t-cun/OrangePiR1-schematics/README.md

# OrangePiR1-schematics
KiCad Schematics and PCB for the Orange Pi R1
