t-cun/OrangePiR1-schematics/KiCad/README.md

# LockboxHomePCB
Kicad Project / PCB files for LockboxHome PCB Design
