t-cun/OrangePiR1-schematics/Fabrication_Files/OrangePiR1_BOM_v1.0.xlsx

Project | OrangePiR1
Date | 2020-04-09
Item # | Designator | Part Number | Description | Manufacturer | Quantity
1 | LP1 | 74404063330 | SMD Inductor, 33uH, 1.22A, 185mOhm | Wurth Elektronik | 1
2 | U2 | RTL8152B | RTL8152B Series,Integrated 10/100M Ethernet Controller, QFN-24 | Realtek | 1
3 | J3 | M20-9990345 | Header, 2.54 mm pitch, 3 Contacts, 1 Row, TH | HARWIN | 1
4 | D30 | PDS5100 | Schottky Diodes, 5 A, 0.89 V, POWERDI-5 | Diodes Incorporated | 1
5 | U58 | MX25L1606EM1I-12G | 16-Mbit (2Mx8) 86 MHz Industrial Grade Serial Flash, SOP-8 | Macronix | 1
6 | D19 | NRVTS260ESF | Schottky Diode, 2A, 60V, SOD-123FL-2 | ON Semiconductor | 1
7 | U21 | CK-W-R189ETV-SM | WIFI module based on Realtek RTL189ETV, 12mm x 12mm x 1.5mm | Lingmeng Technology | 1
8 | U53 | SY8113B | High Efficiency, 500kHz, 3A, 16V Input Synchronous Step Down Regulator, TSOT-23-6 | Silergy Corp | 1
9 | CN5, CN4 | ARJP11A-MASA-B-A-EMU2 | Ethernet Connectors, Magnetic Jack 1 port, 100 Base TX, PCB mount, RA | ABRACON | 2
10 | D10, D11, D12, D13, D14, D15, D16, D17 | S215FA | Schottky Diode, 150V, 2A, SOD-123FA-2 | ON Semiconductor | 8
11 | CP14 | 592D477X06R3C2T20H | Tantalum Capacitor,470uF, 6.3V 20% C case, Solid SMD | Vishay | 1
12 | ANT1 | 2337019-1 | MicroCoax receptacle, SMD | TE Connectivity | 1
13 | U1 | Allwinner H2+ | Allwinner H2+ Quad-core 32-bit Cortex-A7, FBGA 347 balls | Allwinner | 1
14 | DU1 | K4B2G1646F-BYMA | DRAM Chip DDR3 SDRAM 2Gbit 128Mx16 1.5V 96-Pin FBGA | Samsung Electronics | 1
15 | J2 | 105162-0101 | Memory Card Connector, Mirco SD card, with CD pin | Molex | 1
16 | FB10, FB11, FB12, FB13 | BLM18SG331TN1D | Ferrite Bead, 330 ohm, 1.5 A, 0.07 ohm, ± 25%, 0603 | MURATA | 4
17 | FB14 | 742792609 | Ferrite Bead, 0603 [1608 Metric], 30 ohm, 3 A, WE-CBF Series, 0.04 ohm, ± 25% | Wurth Elektronik | 1
18 | U24 | SY6280AAC | PMIC - Power Distribution Switches SOT-23-5 RoHS | Silergy Corp | 1
19 | U54 | SST25VF016B | 16 Mbit SPI Serial Flash, SOIC-8 | Silicon Storage Technology / Microchip | 1
20 | U6 | MIC5219-3.3YM5-TR | Fixed LDO Voltage Regulator, 2.5V to 12V, 350mV Dropout, 3.3Vout, 500mAout, SOT-23-5 | MICROCHIP | 1
21 | U25 | BCM856BS,115 | Bipolar Transistors - BJT COMPLEX DISCRETE S2022D/SOT45 | NXP | 1
22 | Q9 | MMBT3904 | Transistor, NPN, 40 V, 300 MHz, 250 mW, 200 mA, SOT-23 | NXP | 1
23 | Q5 | BSN20-7 | Power MOSFET, N Channel, 50 V, 500 mA, 1.3 ohm, SOT-23 | DIODES INC. | 1
24 | Q10 | AO3415A | MOSFET, P-CH, 20V, 5A, SOT23-3 | Alpha & Omega Semiconductor Inc. | 1
25 | Q11 | AO3423 | MOSFET, P-CH, 20V, 2A, SOT23 | Alpha & Omega Semiconductor Inc. | 1
26 | X2 | TSX-3225 24.0000MF15X-AC6 | CRYSTAL, 24.00MHZ, 9.0PF, SMD | Epson | 1
27 | X5 | TSX-3225 25.0000MF10P-C0 | CRYSTAL 25.0000MHZ 18PF SMD | Epson | 1
28 | CN1 | 10118194-0001LF | USB2.0 Micro Connector, SMD R/A | Amphenol ICC (FCI) | 1
29 | D18 | XBS104S14R-G | DIODE SCHOTTKY, 40V, 1A, SOD123A | Torex Semiconductor Ltd | 1
30 | L3, L8 | SWPA4030S2R2NT | General Purpose Inductor, 2.2uH, 30%, 4.9A, 30mOhms, Ferrite-Core, SMD | SHENZHEN SUNLORD ELECTRONICS CO LTD | 2
31 | L1, L2, L9 | SWPA3015S2R2NT | General Purpose Inductor, 2.2uH, 30%, 1.6A, 60mOhms, Ferrite-Core, SMD | SHENZHEN SUNLORD ELECTRONICS CO LTD | 3
32 | U4, U5, U55 | SY8008B | High Efficiency 1.5MHz, 0.6A/1A/1.2A Synchronous Step Down Regulator, TSOT23-5 | Silergy Corp | 3
33 | U7 | SY8009A | High Efficiency 1.5MHz/1MHz, 1.5A/2A Synchronous Step Down Regulator , SOT23-5 | Silergy Corp | 1
34 | U20 | SI3402-B-GMR | Power Over Ethernet (POE) Controller, 57V Input, 350kHz, QFN-20
35 | D7 | KP-2012SYC | LED, Low Power, Yellow, SMD, 0805, 20 mA, 2 V, 590 nm | KINGBRIGHT | 1
36 | D8 | KP-2012SURC | LED, Low Power, Red, SMD, 0805, 20 mA, 1.9 V, 628 nm | KINGBRIGHT | 1
37 | D49 | KP-2012MGC | LED, Low Power, Green, SMD, 0805, 20mA, 2.1V, 570 nm | KINGBRIGHT | 1
38 | CON5 | 61301311121 | Board-To-Board Connector, Vertical, 2.54 mm, 13 Contacts, Header, TH | WURTH ELEKTRONIK | 1
39 | DR8, RP16 | RC0805FR-07100RL | Chip Resistor, 100 ohm, 150 V, 125 mW, 1%, 0805 | Yageo | 2
40 | R450, R451, R452, R453, RP17, | RC0402FR-07330RL | Chip Resistor, 330 ohm, 50 V, 63 mW, 1%, 0402 | Yageo | 5
41 | R35, R120 | RC0402FR-0733RL | Chip Resistor, 33 ohm, 50 V, 63 mW, 1%, 0402 | Yageo | 2
42 | DR1, DR2, DR5 | RC0402FR-07240RL | Chip Resistor, 240 ohm, 50 V, 63 mW, 1%, 0402 | Yageo | 3
43 | R157, RP15 | RC0402FR-0710KL. | Chip Resistor, 1K ohm, 50 V, 63 mW, 1%, 0402 | Yageo | 2
44 | RP14 | RC0402FR-073K3L | Chip Resistor, 3.3 Kohm, 50 V, 63 mW, 1%, 0402 | Yageo | 1
45 | RP12 | CRCW04023K24FKED | Chip Resistor, 3.24 Kohm, 50 V, 63 mW, 1%, 0402 | Vishay | 1
46 | RP13 | RC0402FR-07180RL | Chip Resistor, 180 ohm, 50 V, 63 mW, 1%, 0402 | Yageo | 1
47 | RP11 | ERJ2RKF4992X | Chip Resistor, 49.9 kohm, 50 V, 100 mW, 1%, 0402 | Panasonic | 1
48 | RP10 | CRCW040224K3FKED | Chip Resistor, 24.3 Kohm, 50 V, 63 mW, 1%, 0402 | Vishay | 1
49 | RP9 | ERJ2RKF4872X | Chip Resistor, 48.7 kohm, 50 V, 100 mW, 1%, 0402 | Panasonic | 1
50 | FB6 | RC0603JR-070RL | Chip Resistor, 0 ohm, 50 V, 100 mW, 1%, 0603
51 | R1, R12, R25, R26, R32, R46, R111, R388, R389, RP1,RP4, RP5, RP8, L10 | RC0402JR-070RL | Chip Resistor, 0 ohm, 50 V, 63 mW, 1%, 0402 | Yageo | 14
52 | DR6, DR7, R131, R132, R151, R152, R153, R154, R461 | RC0402FR-072KL | Chip Resistor, 2K ohm, 50 V, 63 mW, 1%, 0402 | Yageo | 9
53 | R37, R38, R40, R80, R127, R233, R340, R347, R346, R350, R349, R354, R355, R445, R458, R459 | RC0402FR-0710KL. | Chip Resistor, 10K ohm, 50 V, 63 mW, 1%, 0402 | Yageo | 18
54 | R455 | CRCW04022K49FKED | Chip Resistor, 2.49 Kohm, 50 V, 63 mW, 1%, 0402 | Vishay | 1
55 | R3, R18, R22, R449 | RC0402FR-07100KL | Chip Resistor, 100K ohm, 50 V, 63 mW, 1%, 0402 | Yageo | 4
56 | R448 | RC0402FR-0720KL | Chip Resistor, 20K ohm, 50 V, 63 mW, 1%, 0402 | Yageo | 1
57 | R447 | RC0402FR-0733KL | Chip Resistor, 33K ohm, 50 V, 63 mW, 1%, 0402 | Yageo | 1
58 | R13, R446 | RC0402FR-07150KL | Chip Resistor, 150K ohm, 50 V, 63 mW, 1%, 0402 | Yageo | 2
59 | R237 | CRCW040230K1FKED | Chip Resistor, 30.1 Kohm, 50 V, 63 mW, 1%, 0402 | Vishay | 1
60 | R235 | CRCW040211K8FKED | Chip Resistor, 11.8 Kohm, 50 V, 63 mW, 1%, 0402 | Vishay | 1
61 | R2, R16, R33, R34, R112, R113, R114, R115, R116, R117, R118, R123, R124 | RC0402FR-0747KL | Chip Resistor, 47K ohm, 50 V, 63 mW, 1%, 0402 | Yageo | 11
62 | R14, R24 | RC0402FR-07120KL | Chip Resistor, 120K ohm, 50 V, 63 mW, 1%, 0402 | Yageo | 2
63 | R19 | RC0402FR-072RL | Chip Resistor, 2 ohm, 50 V, 63 mW, 1%, 0402 | Yageo | 1
64 | R17 | CRCW0402442KFKED | Chip Resistor, 442K ohm, 50 V, 63 mW, 1%, 0402 | Vishay | 1
65 | R10 | RC0402FR-07220KL | Chip Resistor, 220K ohm, 50 V, 63 mW, 1%, 0402 | Yageo | 1
66 | R5 | CRCW04026K04FKED | Chip Resistor, 6.04K ohm, 50 V, 63 mW, 1%, 0402 | Vishay | 1
67 | C46, C53, C57, C60, C186, C307, C324, C316 | GRM219R61C226ME15L | Chip Capacitor, 22 uF, 16 V, 20%, X5R, 0805 | Murata | 8
68 | C330, C337, C336 | C1206C102KGRACTU | Chip Capacitor, 1 nF, 2 kV, 10%, X7R, 1206 | Kemet | 3
69 | DC2, DC8, CP11, CP19, CP20 | GRM21BR6YA106KE43L | Chip Capacitor, 10 uF, 35V, 10%, X5R, 0805 | Murata | 5
70 | C169, C301, C348 | GRM188R61C475KAAJD | Chip Capacitor, 4.7 uF, 16V, 10%, X5R, 0603 | Murata | 3
71 | C16, C21, C31, C33, C38, C48, C50, C56, C61, C63, C164, C184, C308, C326 | GRM188R61C106KAALD | Chip Capacitor, 10 uF, 16V, 10%, X5R, 0603 | Murata | 14
72 | C45, C52, C325, C59 | GCM1555C1H220JA16D | Chip Capacitor, 22 pF, 50V, 5%, C0G/NP0, 0402 | Murata | 4
73 | C12, C14, C17, C18, C23, C24, C36, C79, C80, C356, C358, CP10, CP12, CP13, DC3, DC4, DC9, DC10, DC21, DC22 | GRM155R61E105KE11D | Chip Capacitor, 1 uF, 25V, 10%, X5R, 0402 | Murata | 20
74 | C1, C2, C4, C6, C7, C8, C9, C10, C15, C19, C20, C25, C26, C30, C32, C34, C39, C47, C49, C51, C54, C55, C58, C62, C65, C165, C181, C183, C185, C287, C288, C323, C327, C332, C333, C334, C335, C340, C345, C346, C347, C353, C354, C355, C357, DC1, DC5, DC6, DC7, DC11, DC12, DC13, DC19, DC20, DC25, DC26 ,DC23, DC24, CP1, CP2, CP3, CP4, CP5, CP6, CP7, CP8, CP9,CP17, CP18, CP21 | GRM155R71C104KA88J | Chip Capacitor, 0.1 uF, 16V, 10%, X7R, 0402 | Murata | 70
75 | CP15 | GCM155R72A102KA37D | Chip Capacitor, 1 nF, 100V, 10%, X7R, 0402 | Murata | 1
76 | C338, C339 | GCM1555C1H270JA16D | Chip Capacitor, 27 pF, 50V, 5%, C0G/NP0, 0402 | Murata | 2
77 | C182 | GCM1555C1H221JA16D | Chip Capacitor, 220 pF, 50V, 5%, C0G/NP0, 0402 | Murata | 1
78 | C160 | GCM1555C1H100JA16D | Chip Capacitor, 10 pF, 50V, 5%, C0G/NP0, 0402 | Murata | 1
79 | C29, C37 | GCM1555C1H180JA16D | Chip Capacitor, 18 pF, 50V, 5%, C0G/NP0, 0402 | Murata | 2
80 | C3, C5, C35 | GRM155R61A475MEAAD | Chip Capacitor, 4.7 uF, 10V, 20%, X5R, 0402 | Murata | 3
OFF-BOARD COMPONENTS
1 | N/A | 204281-1200 | WiFi Antenna 2.4GHz / 5GHz, with 200mm Side Solder Cable, U.FL connector | Molex
