t-cun/OrangePiR1-schematics/KiCad/CPU.sch

## KiCad design KiCad/CPU.sch (2020-04-20)

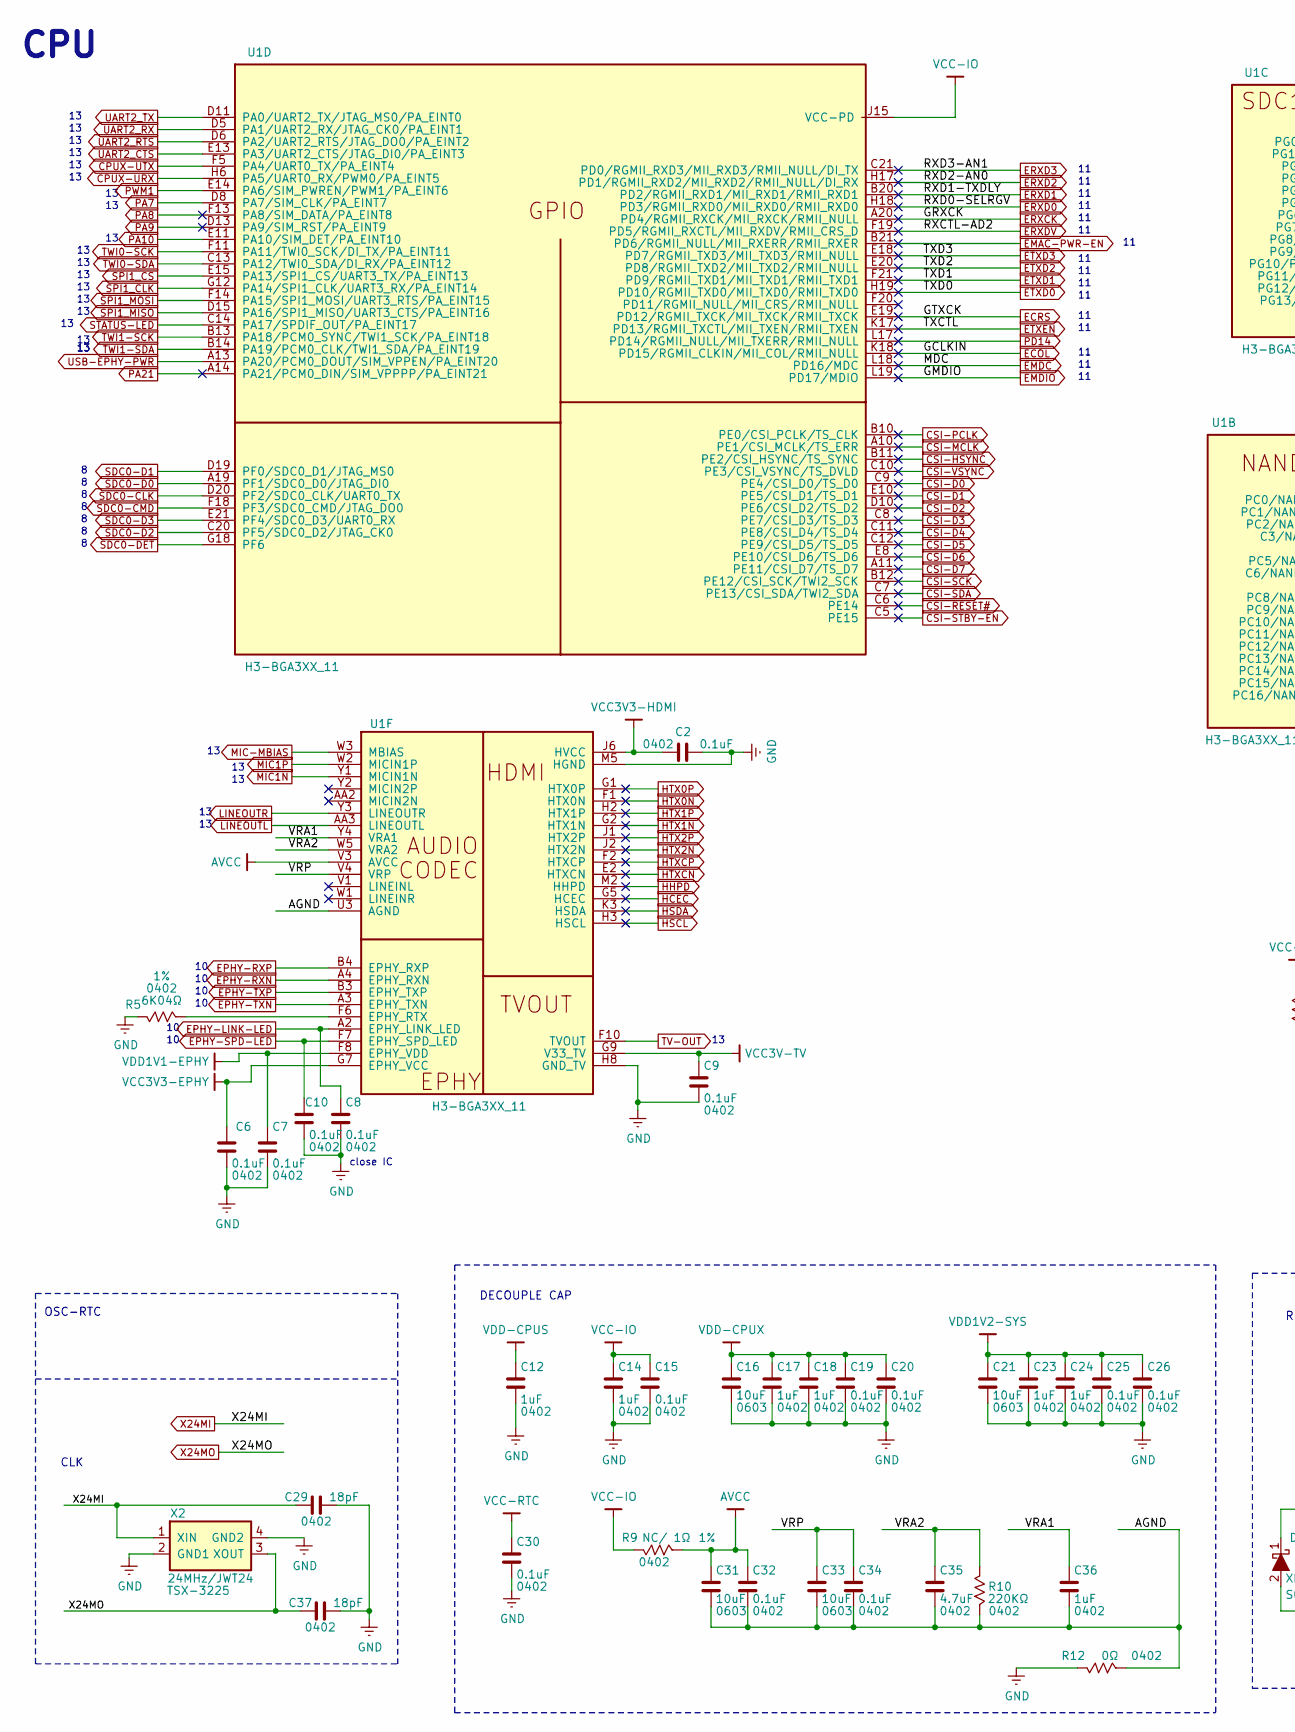
[picture p1: schematic CPU.sch, part in row 1, column 1]

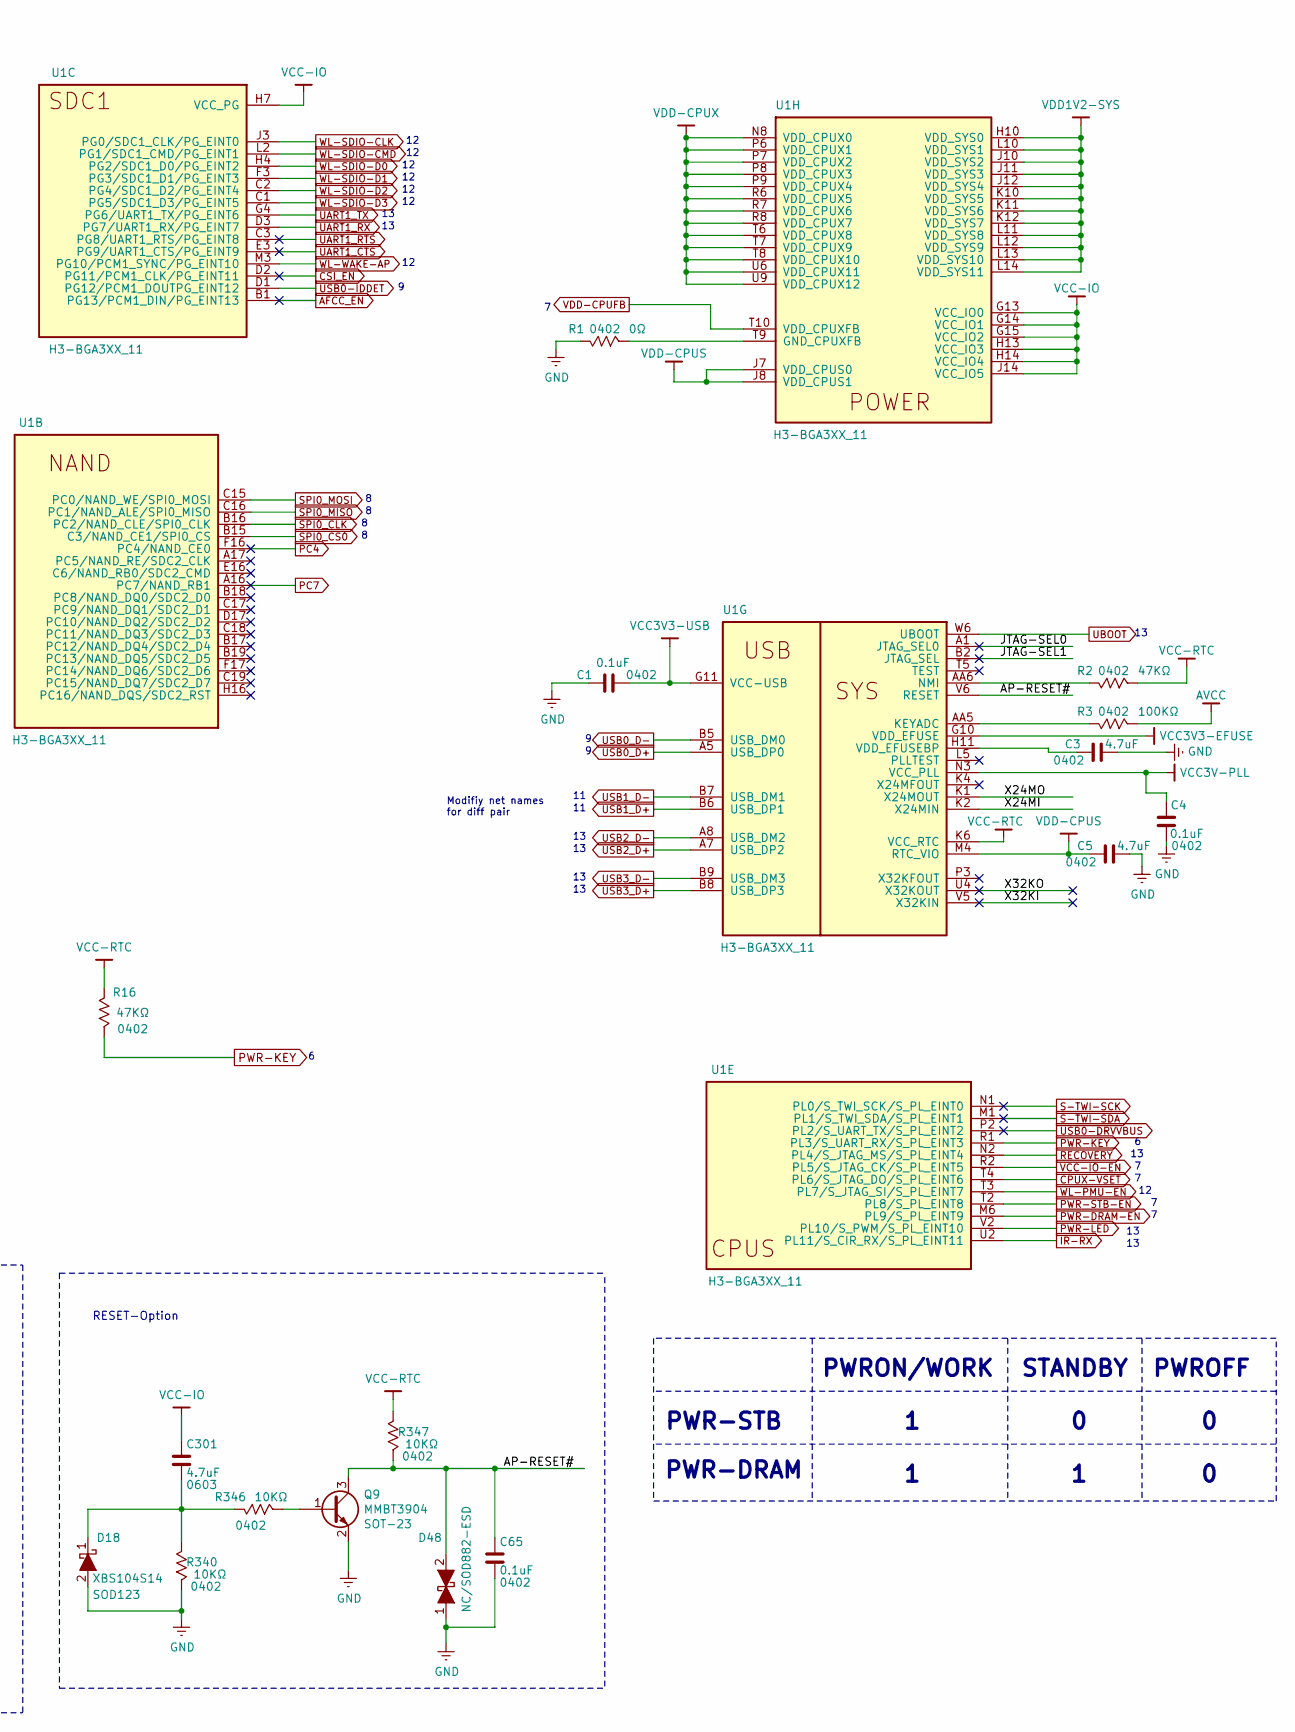
[picture p2: schematic CPU.sch, part in row 1, column 2]

Parts:
C1, C2, C3, C4, C5, C6, C7, C8, C9, C10, C12, C14, C15, C17, C18, C19, C20, C23, C24, C25, C26, C29, C30, C32, C34, C35, C36, C37, C65: CAP0402; Voltage 50V
C16, C21, C31, C33, C301: CAP0603; Voltage 50V
D18: XBS104S14
D48: SOD882-ESD
Q9: MMBT3904
R1, R2, R3, R5, R9, R10, R12, R16, R340, R346, R347: RES402; RES0402; Tolerance 1%
U1: H3-BGA3XX_11
X2: TSX-3225

Connections:
AFCC_EN: U1.B1 (PG13/PCM1_DIN/PG_EINT13)
AGND: C31.2, C32.2, C33.2, C34.2, C35.2, C36.2, R10.1, R12.1, U1.U3 (AGND)
AP-RESET#: C65.1, D48.2 (K), Q9.3 (C), R347.1, U1.V6 (RESET)
AVCC: C31.1, C32.1, R3.1, R9.1, U1.V3 (AVCC)
CPUX-URX: U1.H6 (PA5/UART0_RX/PWM0/PA_EINT5)
CPUX-UTX: U1.F5 (PA4/UART0_TX/PA_EINT4)
CPUX-VSET: U1.T4 (PL6/S_JTAG_DO/S_PL_EINT6)
CSI-D0: U1.C9 (PE4/CSI_D0/TS_D0)
CSI-D1: U1.E10 (PE5/CSI_D1/TS_D1)
CSI-D2: U1.D10 (PE6/CSI_D2/TS_D2)
CSI-D3: U1.C8 (PE7/CSI_D3/TS_D3)
CSI-D4: U1.C11 (PE8/CSI_D4/TS_D4)
CSI-D5: U1.C12 (PE9/CSI_D5/TS_D5)
CSI-D6: U1.E8 (PE10/CSI_D6/TS_D6)
CSI-D7: U1.A11 (PE11/CSI_D7/TS_D7)
CSI-HSYNC: U1.B11 (PE2/CSI_HSYNC/TS_SYNC)
CSI-MCLK: U1.A10 (PE1/CSI_MCLK/TS_ERR)
CSI-PCLK: U1.B10 (PE0/CSI_PCLK/TS_CLK)
CSI-RESET#: U1.C6 (PE14)
CSI-SCK: U1.B12 (PE12/CSI_SCK/TWI2_SCK)
CSI-SDA: U1.C7 (PE13/CSI_SDA/TWI2_SDA)
CSI-STBY-EN: U1.C5 (PE15)
CSI-VSYNC: U1.C10 (PE3/CSI_VSYNC/TS_DVLD)
CSI_EN: U1.D2 (PG11/PCM1_CLK/PG_EINT11)
ECOL: U1.K18 (PD15/RGMII_CLKIN/MII_COL/RMII_NULL)
ECRS: U1.E19 (PD12/RGMII_TXCK/MII_TXCK/RMII_TXCK)
EMAC-PWR-EN: U1.B21 (PD6/RGMII_NULL/MII_RXERR/RMII_RXER)
EMDC: U1.L18 (PD16/MDC)
EMDIO: U1.L19 (PD17/MDIO)
EPHY-LINK-LED: C8.1, U1.A2 (EPHY_LINK_LED)
EPHY-RXN: U1.A4 (EPHY_RXN)
EPHY-RXP: U1.B4 (EPHY_RXP)
EPHY-SPD-LED: C10.1, U1.F7 (EPHY_SPD_LED)
EPHY-TXN: U1.A3 (EPHY_TXN)
EPHY-TXP: U1.B3 (EPHY_TXP)
ERXCK: U1.A20 (PD4/RGMII_RXCK/MII_RXCK/RMII_NULL)
ERXD0: U1.H18 (PD3/RGMII_RXD0/MII_RXD0/RMII_RXD0)
ERXD1: U1.B20 (PD2/RGMII_RXD1/MII_RXD1/RMII_RXD1)
ERXD2: U1.H17 (PD1/RGMII_RXD2/MII_RXD2/RMII_NULL/DI_RX)
ERXD3: U1.C21 (PD0/RGMII_RXD3/MII_RXD3/RMII_NULL/DI_TX)
ERXDV: U1.F19 (PD5/RGMII_RXCTL/MII_RXDV/RMII_CRS_D)
ETXD0: U1.H19 (PD10/RGMII_TXD0/MII_TXD0/RMII_TXD0)
ETXD1: U1.F21 (PD9/RGMII_TXD1/MII_TXD1/RMII_TXD1)
ETXD2: U1.E20 (PD8/RGMII_TXD2/MII_TXD2/RMII_NULL)
ETXD3: U1.E18 (PD7/RGMII_TXD3/MII_TXD3/RMII_NULL)
ETXEN: U1.K17 (PD13/RGMII_TXCTL/MII_TXEN/RMII_TXEN)
GND: C1.2, C2.1, C3.1, C4.2, C5.1, C6.2, C7.2, C8.2, C9.2, C10.2, C12.2, C14.2, C15.2, C16.2, C17.2, C18.2, C19.2, C20.2, C21.2, C23.2, C24.2, C25.2, C26.2, C29.1, C30.2, C37.1, C65.2, D18.2 (A), D48.1 (A), Q9.2 (E), R1.2, R5.2, R12.2, R340.1, U1.H8 (GND_TV), U1.M5 (HGND), X2.2 (GND1), X2.4 (GND2)
HCEC: U1.G5 (HCEC)
HHPD: U1.M2 (HHPD)
HSCL: U1.H3 (HSCL)
HSDA: U1.K3 (HSDA)
HTX0N: U1.F1 (HTX0N)
HTX0P: U1.G1 (HTX0P)
HTX1N: U1.G2 (HTX1N)
HTX1P: U1.H2 (HTX1P)
HTX2N: U1.J2 (HTX2N)
HTX2P: U1.J1 (HTX2P)
HTXCN: U1.E2 (HTXCN)
HTXCP: U1.F2 (HTXCP)
IR-RX: U1.U2 (PL11/S_CIR_RX/S_PL_EINT11)
JTAG-SEL0: U1.A1 (JTAG_SEL0)
JTAG-SEL1: U1.B2 (JTAG_SEL)
LINEOUTL: U1.AA3 (LINEOUTL)
LINEOUTR: U1.Y3 (LINEOUTR)
MIC1N: U1.Y1 (MICIN1N)
MIC1P: U1.W2 (MICIN1P)
MIC-MBIAS: U1.W3 (MBIAS)
unnamed: C3.2, U1.H11 (VDD_EFUSEBP)
unnamed: C301.2, D18.1 (K), R340.2, R346.2
unnamed: Q9.1 (B), R346.1
unnamed: R1.1, U1.T9 (GND_CPUXFB)
unnamed: R2.2, U1.AA6 (NMI)
unnamed: R3.2, U1.AA5 (KEYADC)
unnamed: R5.1, U1.F6 (EPHY_RTX)
PA7: U1.D8 (PA7/SIM_CLK/PA_EINT7)
PA8: U1.F13 (PA8/SIM_DATA/PA_EINT8)
PA9: U1.D13 (PA9/SIM_RST/PA_EINT9)
PA10: U1.E11 (PA10/SIM_DET/PA_EINT10)
PA21: U1.A14 (PA21/PCM0_DIN/SIM_VPPPP/PA_EINT21)
PC4: U1.F16 (PC4/NAND_CE0)
PC7: U1.A16 (PC7/NAND_RB1)
PD14: U1.L17 (PD14/RGMII_NULL/MII_TXERR/RMII_NULL)
PWM1: U1.E14 (PA6/SIM_PWREN/PWM1/PA_EINT6)
PWR-DRAM-EN: U1.M6 (PL9/S_PL_EINT9)
PWR-KEY: R16.1, U1.R1 (PL3/S_UART_RX/S_PL_EINT3)
PWR-LED: U1.V2 (PL10/S_PWM/S_PL_EINT10)
PWR-STB-EN: U1.T2 (PL8/S_PL_EINT8)
RECOVERY: U1.N2 (PL4/S_JTAG_MS/S_PL_EINT4)
S-TWI-SCK: U1.N1 (PL0/S_TWI_SCK/S_PL_EINT0)
S-TWI-SDA: U1.M1 (PL1/S_TWI_SDA/S_PL_EINT1)
SDC0-CLK: U1.D20 (PF2/SDC0_CLK/UART0_TX)
SDC0-CMD: U1.F18 (PF3/SDC0_CMD/JTAG_DO0)
SDC0-D0: U1.A19 (PF1/SDC0_D0/JTAG_DI0)
SDC0-D1: U1.D19 (PF0/SDC0_D1/JTAG_MS0)
SDC0-D2: U1.C20 (PF5/SDC0_D2/JTAG_CK0)
SDC0-D3: U1.E21 (PF4/SDC0_D3/UART0_RX)
SDC0-DET: U1.G18 (PF6)
SPI0_CLK: U1.B16 (PC2/NAND_CLE/SPI0_CLK)
SPI0_CS0: U1.B15 (C3/NAND_CE1/SPI0_CS)
SPI0_MISO: U1.C16 (PC1/NAND_ALE/SPI0_MISO)
SPI0_MOSI: U1.C15 (PC0/NAND_WE/SPI0_MOSI)
SPI1_CLK: U1.G12 (PA14/SPI1_CLK/UART3_RX/PA_EINT14)
SPI1_CS: U1.E15 (PA13/SPI1_CS/UART3_TX/PA_EINT13)
SPI1_MISO: U1.D15 (PA16/SPI1_MISO/UART3_CTS/PA_EINT16)
SPI1_MOSI: U1.F14 (PA15/SPI1_MOSI/UART3_RTS/PA_EINT15)
STATUS-LED: U1.C14 (PA17/SPDIF_OUT/PA_EINT17)
TV-OUT: U1.F10 (TVOUT)
TWI0-SCK: U1.F11 (PA11/TWI0_SCK/DI_TX/PA_EINT11)
TWI0-SDA: U1.C13 (PA12/TWI0_SDA/DI_RX/PA_EINT12)
TWI1-SCK: U1.B13 (PA18/PCM0_SYNC/TWI1_SCK/PA_EINT18)
TWI1-SDA: U1.B14 (PA19/PCM0_CLK/TWI1_SDA/PA_EINT19)
UART1_CTS: U1.E3 (PG9/UART1_CTS/PG_EINT9)
UART1_RTS: U1.C3 (PG8/UART1_RTS/PG_EINT8)
UART1_RX: U1.D3 (PG7/UART1_RX/PG_EINT7)
UART1_TX: U1.G4 (PG6/UART1_TX/PG_EINT6)
UART2_CTS: U1.E13 (PA3/UART2_CTS/JTAG_DI0/PA_EINT3)
UART2_RTS: U1.D6 (PA2/UART2_RTS/JTAG_DO0/PA_EINT2)
UART2_RX: U1.D5 (PA1/UART2_RX/JTAG_CK0/PA_EINT1)
UART2_TX: U1.D11 (PA0/UART2_TX/JTAG_MS0/PA_EINT0)
UBOOT: U1.W6 (UBOOT)
USB0-DRVVBUS: U1.P2 (PL2/S_UART_TX/S_PL_EINT2)
USB0-IDDET: U1.D1 (PG12/PCM1_DOUTPG_EINT12)
USB0_D+: U1.A5 (USB_DP0)
USB0_D-: U1.B5 (USB_DM0)
USB1_D+: U1.B6 (USB_DP1)
USB1_D-: U1.B7 (USB_DM1)
USB2_D+: U1.A7 (USB_DP2)
USB2_D-: U1.A8 (USB_DM2)
USB3_D+: U1.B8 (USB_DP3)
USB3_D-: U1.B9 (USB_DM3)
USB-EPHY-PWR: U1.A13 (PA20/PCM0_DOUT/SIM_VPPEN/PA_EINT20)
VCC3V3-EFUSE: U1.G10 (VDD_EFUSE)
VCC3V3-EPHY: C6.1, U1.G7 (EPHY_VCC)
VCC3V3-HDMI: C2.2, U1.J6 (HVCC)
VCC3V3-USB: C1.1, U1.G11 (VCC-USB)
VCC3V-PLL: C4.1, U1.N3 (VCC_PLL)
VCC3V-TV: C9.1, U1.G9 (V33_TV)
VCC-IO: C14.1, C15.1, C301.1, R9.2, U1.G13 (VCC_IO0), U1.G14 (VCC_IO1), U1.G15 (VCC_IO2), U1.H7 (VCC_PG), U1.H13 (VCC_IO3), U1.H14 (VCC_IO4), U1.J14 (VCC_IO5), U1.J15 (VCC-PD)
VCC-IO-EN: U1.R2 (PL5/S_JTAG_CK/S_PL_EINT5)
VCC-RTC: C30.1, R2.1, R16.2, R347.2, U1.K6 (VCC_RTC)
VDD1V1-EPHY: C7.1, U1.F8 (EPHY_VDD)
VDD1V2-SYS: C21.1, C23.1, C24.1, C25.1, C26.1, U1.H10 (VDD_SYS0), U1.J10 (VDD_SYS2), U1.J11 (VDD_SYS3), U1.J12 (VDD_SYS4), U1.K10 (VDD_SYS5), U1.K11 (VDD_SYS6), U1.K12 (VDD_SYS7), U1.L10 (VDD_SYS1), U1.L11 (VDD_SYS8), U1.L12 (VDD_SYS9), U1.L13 (VDD_SYS10), U1.L14 (VDD_SYS11)
VDD-CPUFB: U1.T10 (VDD_CPUXFB)
VDD-CPUS: C5.2, C12.1, U1.J7 (VDD_CPUS0), U1.J8 (VDD_CPUS1), U1.M4 (RTC_VIO)
VDD-CPUX: C16.1, C17.1, C18.1, C19.1, C20.1, U1.N8 (VDD_CPUX0), U1.P6 (VDD_CPUX1), U1.P7 (VDD_CPUX2), U1.P8 (VDD_CPUX3), U1.P9 (VDD_CPUX4), U1.R6 (VDD_CPUX5), U1.R7 (VDD_CPUX6), U1.R8 (VDD_CPUX7), U1.T6 (VDD_CPUX8), U1.T7 (VDD_CPUX9), U1.T8 (VDD_CPUX10), U1.U6 (VDD_CPUX11), U1.U9 (VDD_CPUX12)
VRA1: C36.1, U1.Y4 (VRA1)
VRA2: C35.1, R10.2, U1.W5 (VRA2)
VRP: C33.1, C34.1, U1.V4 (VRP)
WL-PMU-EN: U1.T3 (PL7/S_JTAG_SI/S_PL_EINT7)
WL-SDIO-CLK: U1.J3 (PG0/SDC1_CLK/PG_EINT0)
WL-SDIO-CMD: U1.L2 (PG1/SDC1_CMD/PG_EINT1)
WL-SDIO-D0: U1.H4 (PG2/SDC1_D0/PG_EINT2)
WL-SDIO-D1: U1.F3 (PG3/SDC1_D1/PG_EINT3)
WL-SDIO-D2: U1.C2 (PG4/SDC1_D2/PG_EINT4)
WL-SDIO-D3: U1.C1 (PG5/SDC1_D3/PG_EINT5)
WL-WAKE-AP: U1.M3 (PG10/PCM1_SYNC/PG_EINT10)
X24MI: C29.2, U1.K2 (X24MIN), X2.1 (XIN)
X24MO: C37.2, U1.K1 (X24MOUT), X2.3 (XOUT)
X32KI: U1.V5 (X32KIN)
X32KO: U1.U4 (X32KOUT)

Notes on the sheet:
close IC
Modifiy net names for diff pair
PWRON/WORK
STANDBY
PWROFF
PWR-STB
PWR-DRAM
CLK
OSC-RTC
DECOUPLE CAP
RESET-Option
CPU
