t-cun/OrangePiR1-schematics/KiCad/EMAC.sch

## KiCad design KiCad/EMAC.sch (2020-04-20)

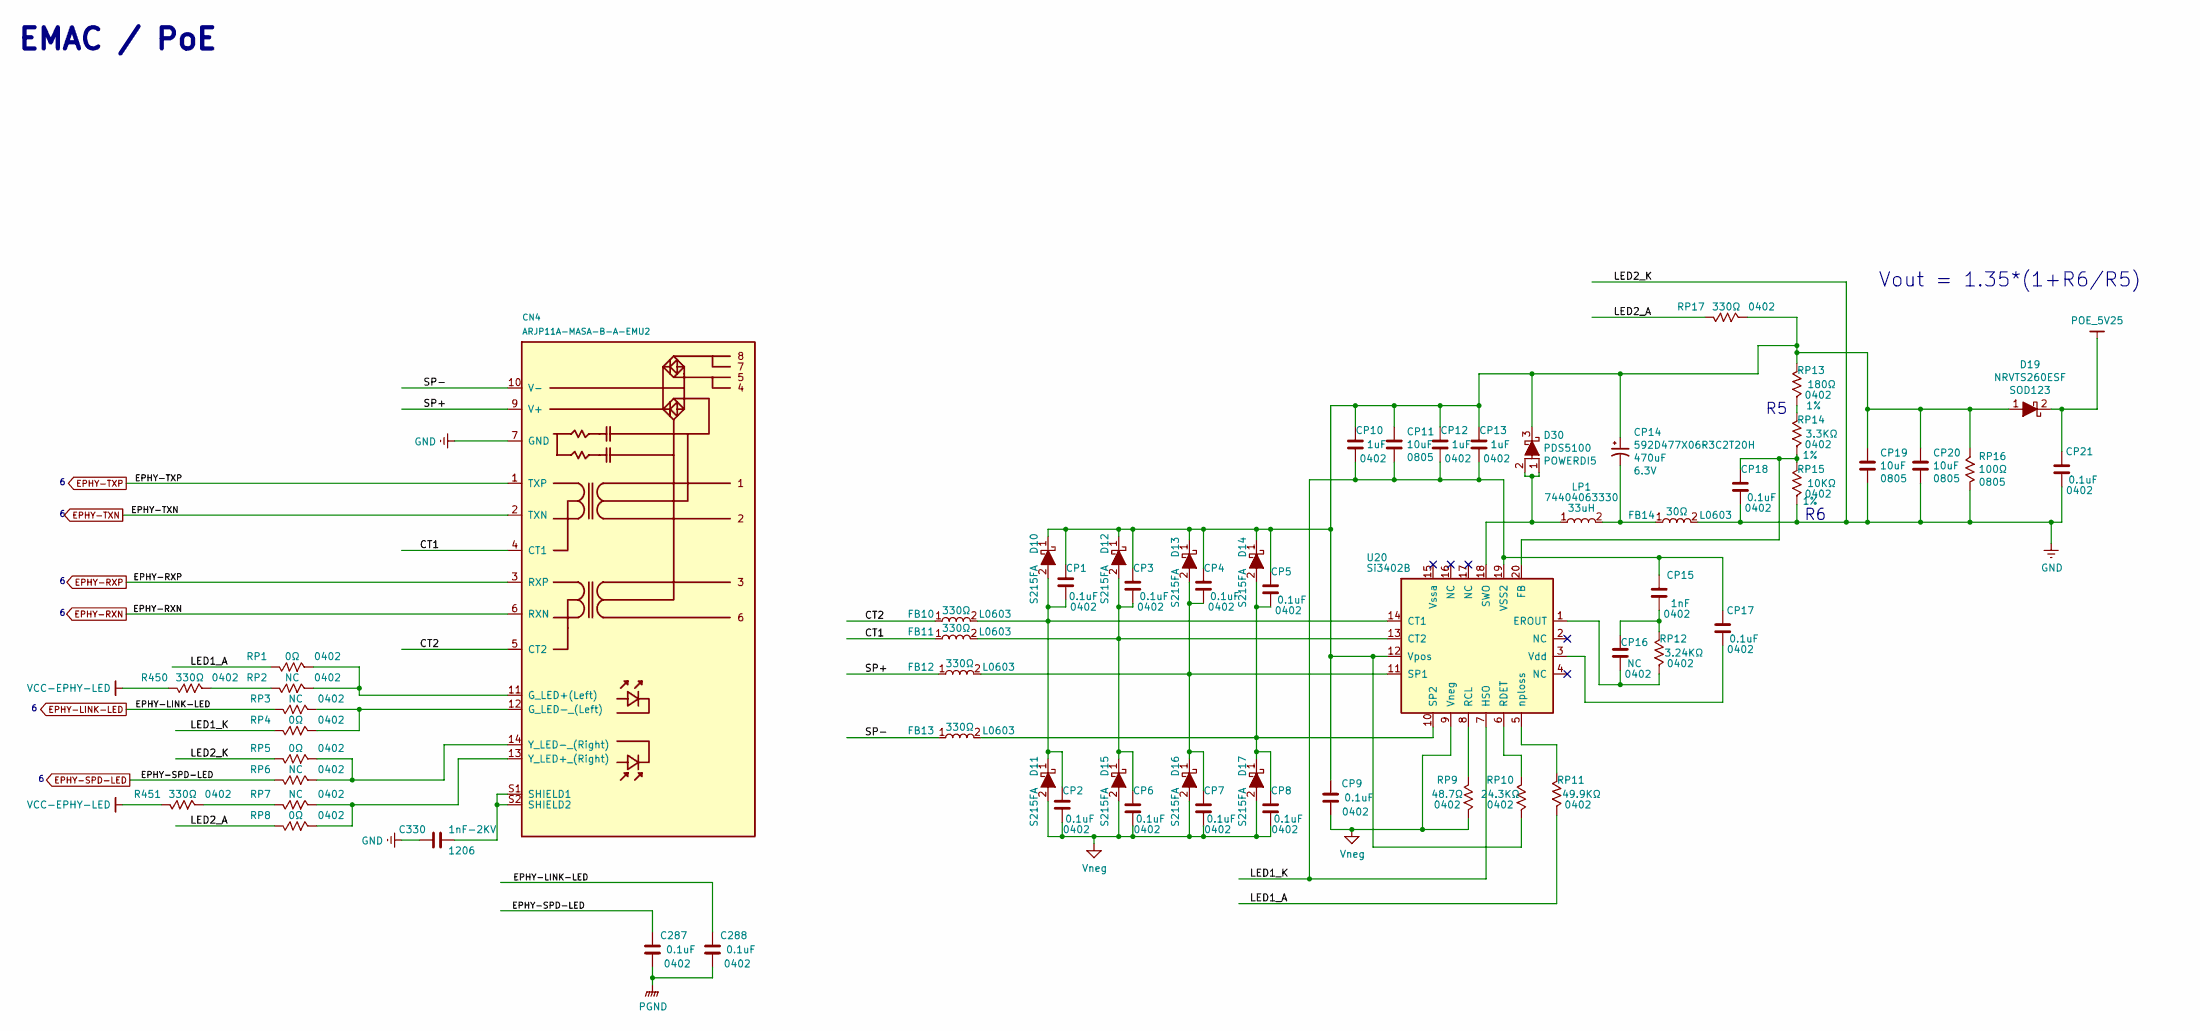
[picture p4: schematic EMAC.sch]

Parts:
C287, C288: CAP0402; Voltage 50V
C330: CAP1206; Voltage 50V
CN4: ARJP11A-MASA-B-A-EMU2
CP1, CP2, CP3, CP4, CP5, CP6, CP7, CP8, CP9, CP10, CP12, CP13, CP15, CP16, CP17, CP18, CP21: CAP0402; Voltage 50V
CP11, CP19, CP20: CAP0805; Voltage 50V
CP14: 592D477X06R3C2T20H; Voltage 6.3V
D10, D11, D12, D13, D14, D15, D16, D17: S215FA
D19: NRVTS260ESF
D30: PDS5100
FB10, FB11, FB12, FB13, FB14: L0603
LP1: 74404063330
R450, R451: RES402; RES0402; Tolerance x%
RP1, RP2, RP3, RP4, RP5, RP6, RP7, RP8, RP9, RP10, RP11, RP12, RP17: RES402; RES0402; Tolerance x%
RP13, RP14, RP15: RES402; RES0402; Tolerance 1%
RP16: RES0805; Tolerance x%
U20: Si3402B

Connections:
CT1: CN4.4 (CT1), FB11.1
CT2: CN4.5 (CT2), FB10.1
EPHY-LINK-LED: C288.2, RP3.2
EPHY-RXN: CN4.6 (RXN)
EPHY-RXP: CN4.3 (RXP)
EPHY-SPD-LED: C287.2, RP6.2
EPHY-TXN: CN4.2 (TXN)
EPHY-TXP: CN4.1 (TXP)
GND: C330.2, CN4.7 (GND), CP18.1, CP19.2, CP20.2, CP21.1, FB14.2, RP5.2, RP15.1, RP16.2
LED1_A: RP1.2, RP11.1
LED1_K: CP10.1, CP11.2, CP12.1, CP13.1, CP15.2, CP17.2, RP4.2, U20.7 (HSO), U20.19 (VSS2)
LED2_A: RP8.2, RP17.2
unnamed: C330.1, CN4.S1 (SHIELD1), CN4.S2 (SHIELD2)
unnamed: CN4.11 (G_LED+(Left)), RP1.1, RP2.1
unnamed: CN4.12 (G_LED-_(Left)), RP3.1, RP4.1
unnamed: CN4.13 (Y_LED+_(Right)), RP7.1, RP8.1
unnamed: CN4.14 (Y_LED-_(Right)), RP5.1, RP6.1
unnamed: CP1.1, CP2.2, D10.2 (A), D11.1 (K), FB10.2, U20.14 (CT1)
unnamed: CP1.2, CP3.2, CP4.2, CP5.2, CP9.2, CP10.2, CP11.1, CP12.2, CP13.2, CP14.1, CP19.1, CP20.1, D10.1 (K), D12.1 (K), D13.1 (K), D14.1 (K), D19.1 (A), D30.3 (K), RP10.1, RP13.2, RP16.1, RP17.1, U20.12 (Vpos)
unnamed: CP3.1, CP6.2, D12.2 (A), D15.1 (K), FB11.2, U20.13 (CT2)
unnamed: CP4.1, CP7.2, D13.2 (A), D16.1 (K), FB12.2, U20.11 (SP1)
unnamed: CP5.1, CP8.2, D14.2 (A), D17.1 (K), FB13.2, U20.10 (SP2)
unnamed: CP14.2, FB14.1, LP1.2
unnamed: CP15.1, CP16.2, RP12.2
unnamed: CP16.1, RP12.1, U20.1 (EROUT)
unnamed: CP17.1, U20.3 (Vdd)
unnamed: CP18.2, RP14.1, RP15.2, U20.20 (FB)
unnamed: D30.1 (A), D30.2, LP1.1, U20.18 (SWO)
unnamed: R450.1, RP2.2
unnamed: R451.1, RP7.2
unnamed: RP9.2, U20.8 (RCL)
unnamed: RP10.2, U20.6 (RDET)
unnamed: RP11.2, U20.5 (nploss)
unnamed: RP13.1, RP14.2
PGND: C287.1, C288.1
POE_5V25: CP21.2, D19.2 (K)
SP+: CN4.9 (V+), FB12.1
SP-: CN4.10 (V-), FB13.1
VCC-EPHY-LED: R450.2, R451.2
Vneg: CP2.1, CP6.1, CP7.1, CP8.1, CP9.1, D11.2 (A), D15.2 (A), D16.2 (A), D17.2 (A), RP9.1, U20.9 (Vneg)

Notes on the sheet:
EMAC / PoE
Vout = 1.35*(1+R6/R5)
