t-cun/OrangePiR1-schematics/KiCad/EXT.sch

## KiCad design KiCad/EXT.sch (2020-04-20)

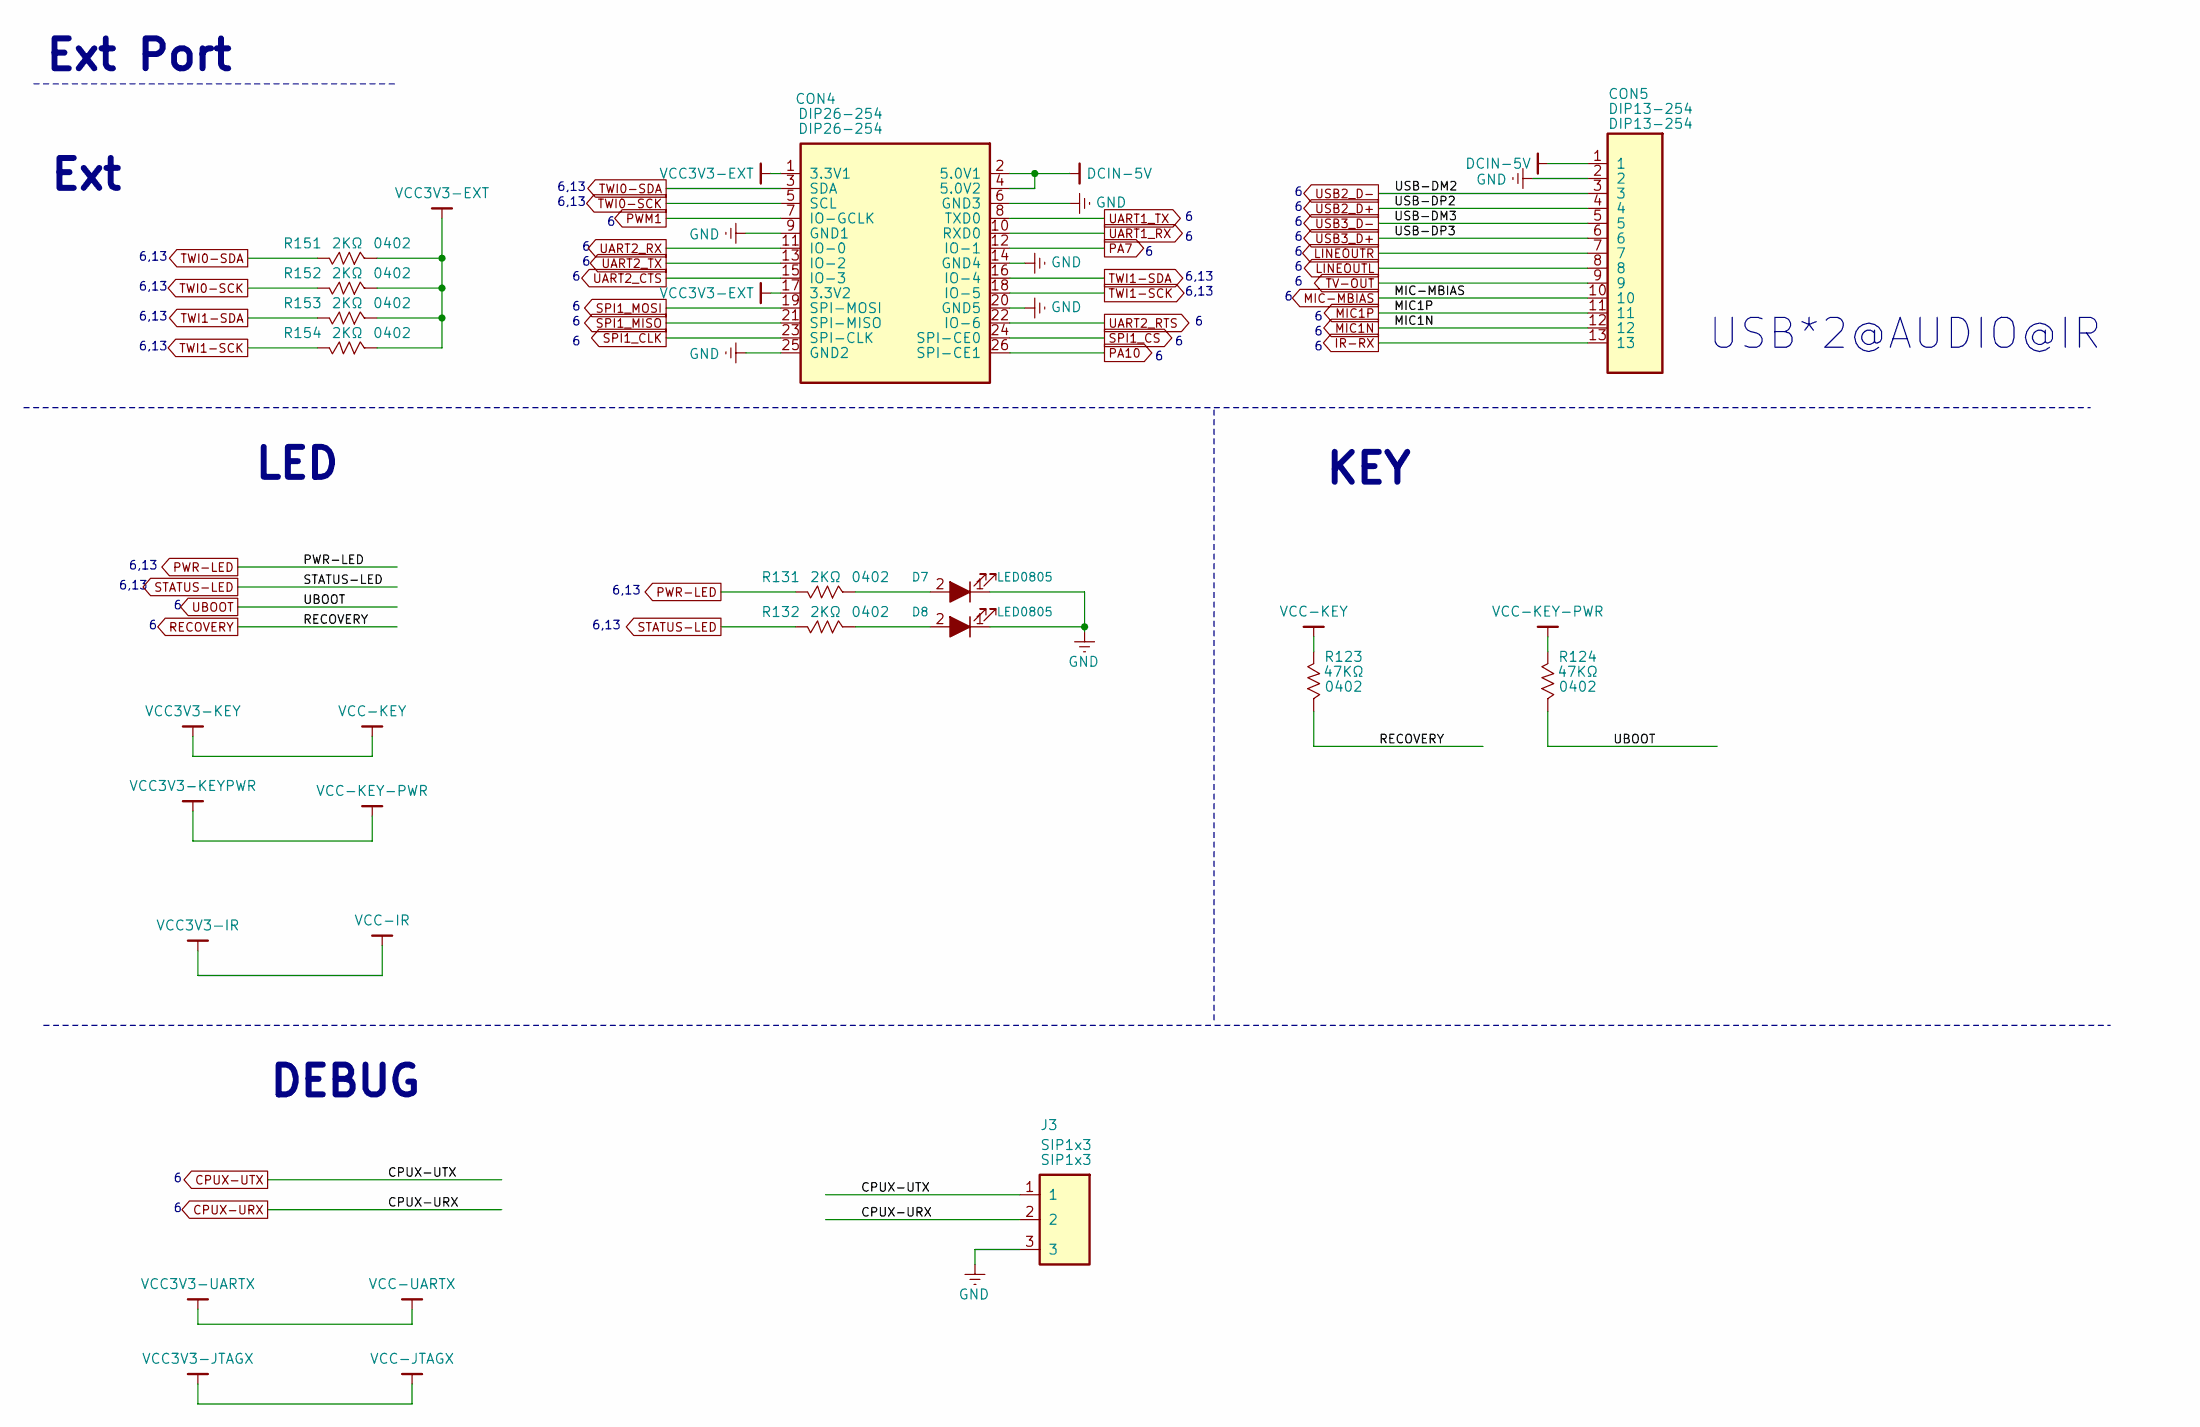
[picture p5: schematic EXT.sch]

Parts:
CON4: DIP26-254
CON5: DIP13-254
D7, D8: LED0805
J3: SIP1x3
R123, R124, R131, R132, R151, R152, R153, R154: RES402; RES0402; Tolerance x%

Connections:
CPUX-URX: J3.2
CPUX-UTX: J3.1
DCIN-5V: CON4.2 (5.0V1), CON4.4 (5.0V2), CON5.1
GND: CON4.6 (GND3), CON4.9 (GND1), CON4.14 (GND4), CON4.20 (GND5), CON4.25 (GND2), CON5.2, D7.1 (K), D8.1 (K), J3.3
IR-RX: CON5.13
LINEOUTL: CON5.8
LINEOUTR: CON5.7
MIC1N: CON5.12
MIC1P: CON5.11
MIC-MBIAS: CON5.10
unnamed: D7.2 (A), R131.1
unnamed: D8.2 (A), R132.1
PA7: CON4.12 (IO-1)
PA10: CON4.26 (SPI-CE1)
PWM1: CON4.7 (IO-GCLK)
PWR-LED: R131.2
RECOVERY: R123.1
SPI1_CLK: CON4.23 (SPI-CLK)
SPI1_CS: CON4.24 (SPI-CE0)
SPI1_MISO: CON4.21 (SPI-MISO)
SPI1_MOSI: CON4.19 (SPI-MOSI)
STATUS-LED: R132.2
TV-OUT: CON5.9
TWI0-SCK: CON4.5 (SCL), R152.2
TWI0-SDA: CON4.3 (SDA), R151.2
TWI1-SCK: CON4.18 (IO-5), R154.2
TWI1-SDA: CON4.16 (IO-4), R153.2
UART1_RX: CON4.10 (RXD0)
UART1_TX: CON4.8 (TXD0)
UART2_CTS: CON4.15 (IO-3)
UART2_RTS: CON4.22 (IO-6)
UART2_RX: CON4.11 (IO-0)
UART2_TX: CON4.13 (IO-2)
UBOOT: R124.1
USB2_D+: CON5.4
USB2_D-: CON5.3
USB3_D+: CON5.6
USB3_D-: CON5.5
VCC3V3-EXT: CON4.1 (3.3V1), CON4.17 (3.3V2), R151.1, R152.1, R153.1, R154.1
VCC-KEY: R123.2
VCC-KEY-PWR: R124.2

Notes on the sheet:
6,13
Ext Port
Ext
USB*2@AUDIO@IR
LED
KEY
DEBUG
