t-cun/OrangePiR1-schematics/KiCad/NOR FLASH-TF.sch

## KiCad design KiCad/NOR FLASH-TF.sch (2020-04-20)

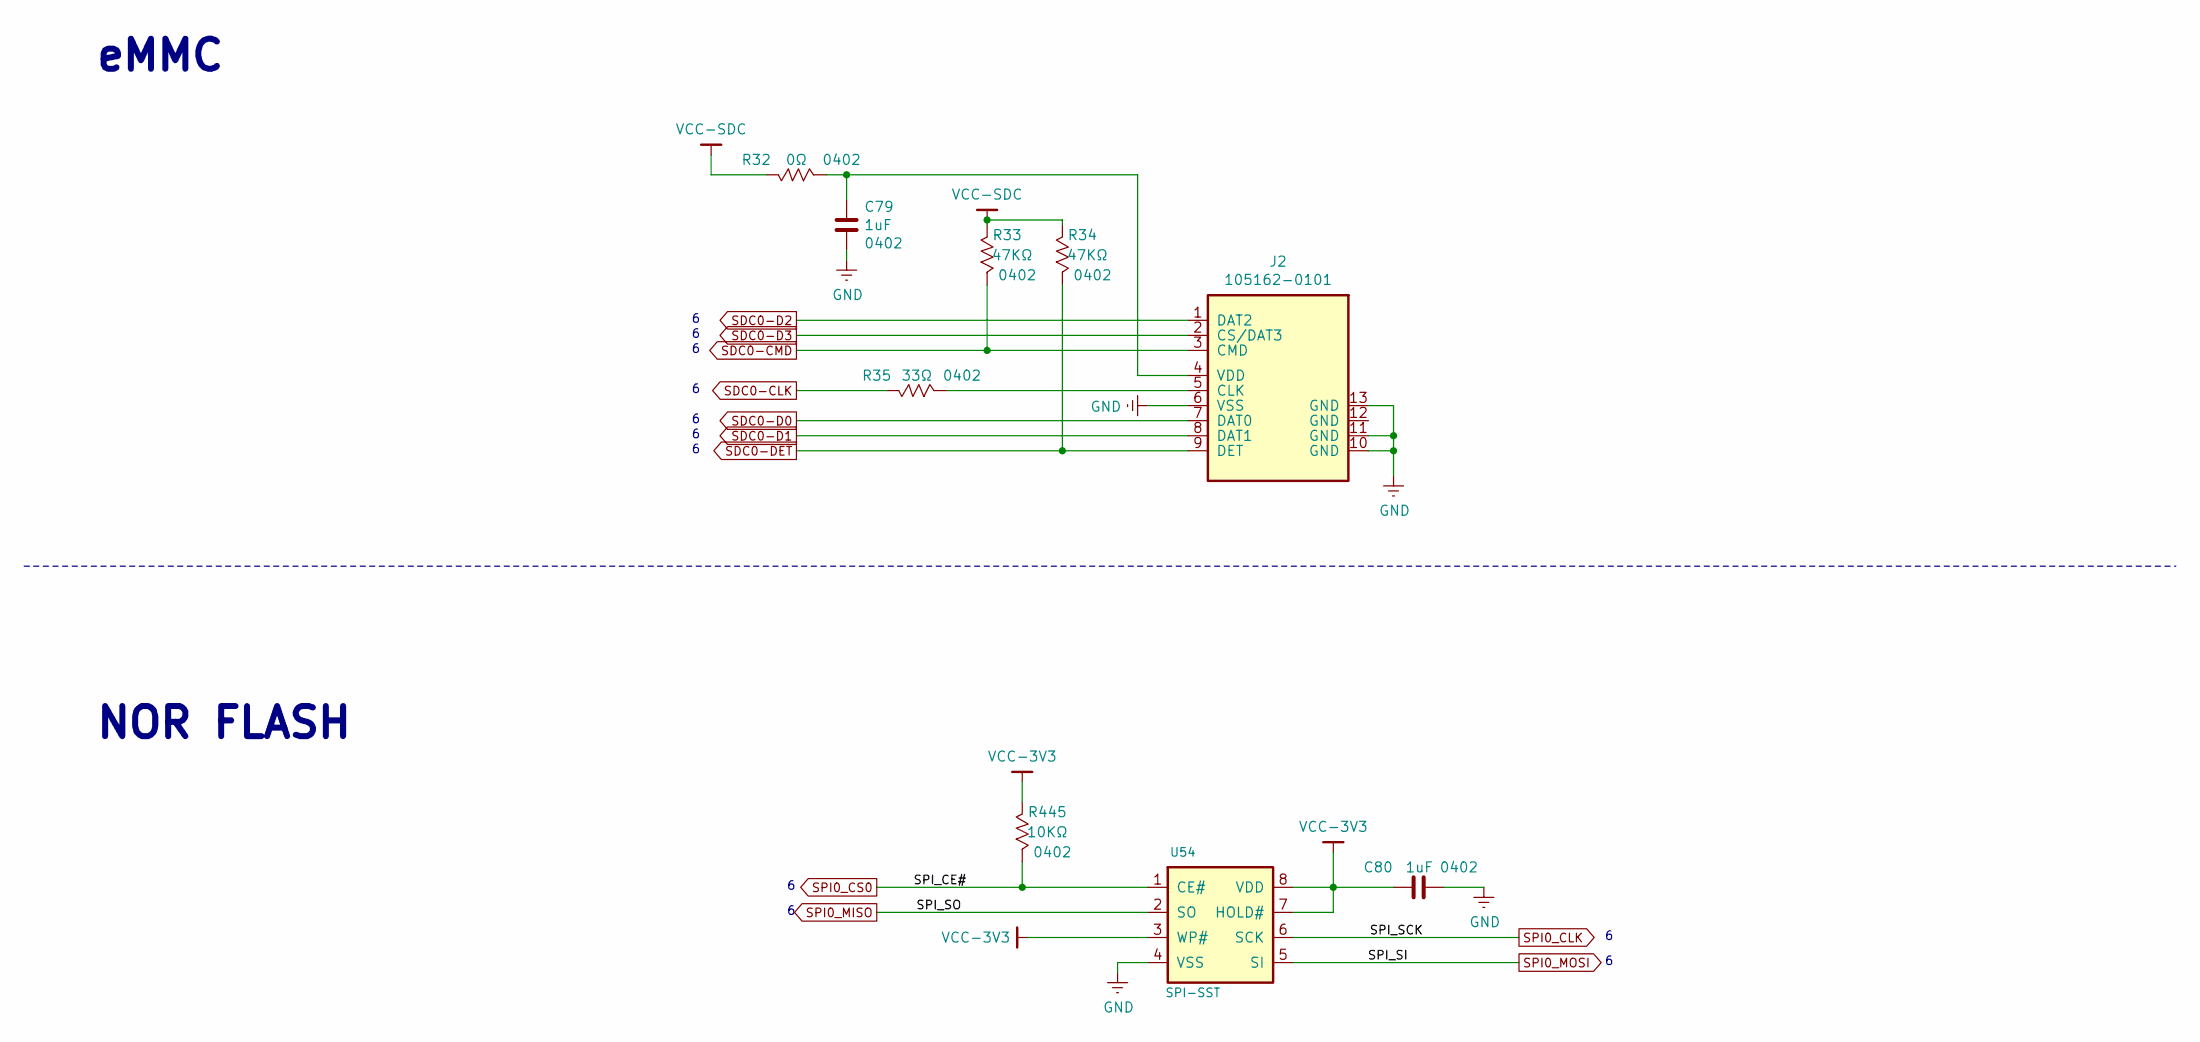
[picture p6: schematic NOR FLASH-TF.sch]

Parts:
C79, C80: CAP0402; Voltage 50V
J2: 105162-0101
R32, R33, R34, R35, R445: RES402; RES0402; Tolerance x%
U54: SPI-SST

Connections:
GND: C79.2, C80.2, J2.6 (VSS), J2.10 (GND), J2.11 (GND), J2.13 (GND), U54.4 (VSS)
unnamed: C79.1, J2.4 (VDD), R32.1
unnamed: J2.5 (CLK), R35.1
SDC0-CLK: R35.2
SDC0-CMD: J2.3 (CMD), R33.1
SDC0-D0: J2.7 (DAT0)
SDC0-D1: J2.8 (DAT1)
SDC0-D2: J2.1 (DAT2)
SDC0-D3: J2.2 (CS/DAT3)
SDC0-DET: J2.9 (DET), R34.1
SPI0_CLK: U54.6 (SCK)
SPI0_CS0: R445.1, U54.1 (CE#)
SPI0_MISO: U54.2 (SO)
SPI0_MOSI: U54.5 (SI)
VCC-3V3: C80.1, R445.2, U54.3 (WP#), U54.7 (HOLD#), U54.8 (VDD)
VCC-SDC: R32.2, R33.2, R34.2

Notes on the sheet:
eMMC
NOR FLASH
