t-cun/OrangePiR1-schematics/KiCad/POWER.sch

## KiCad design KiCad/POWER.sch (2020-04-20)

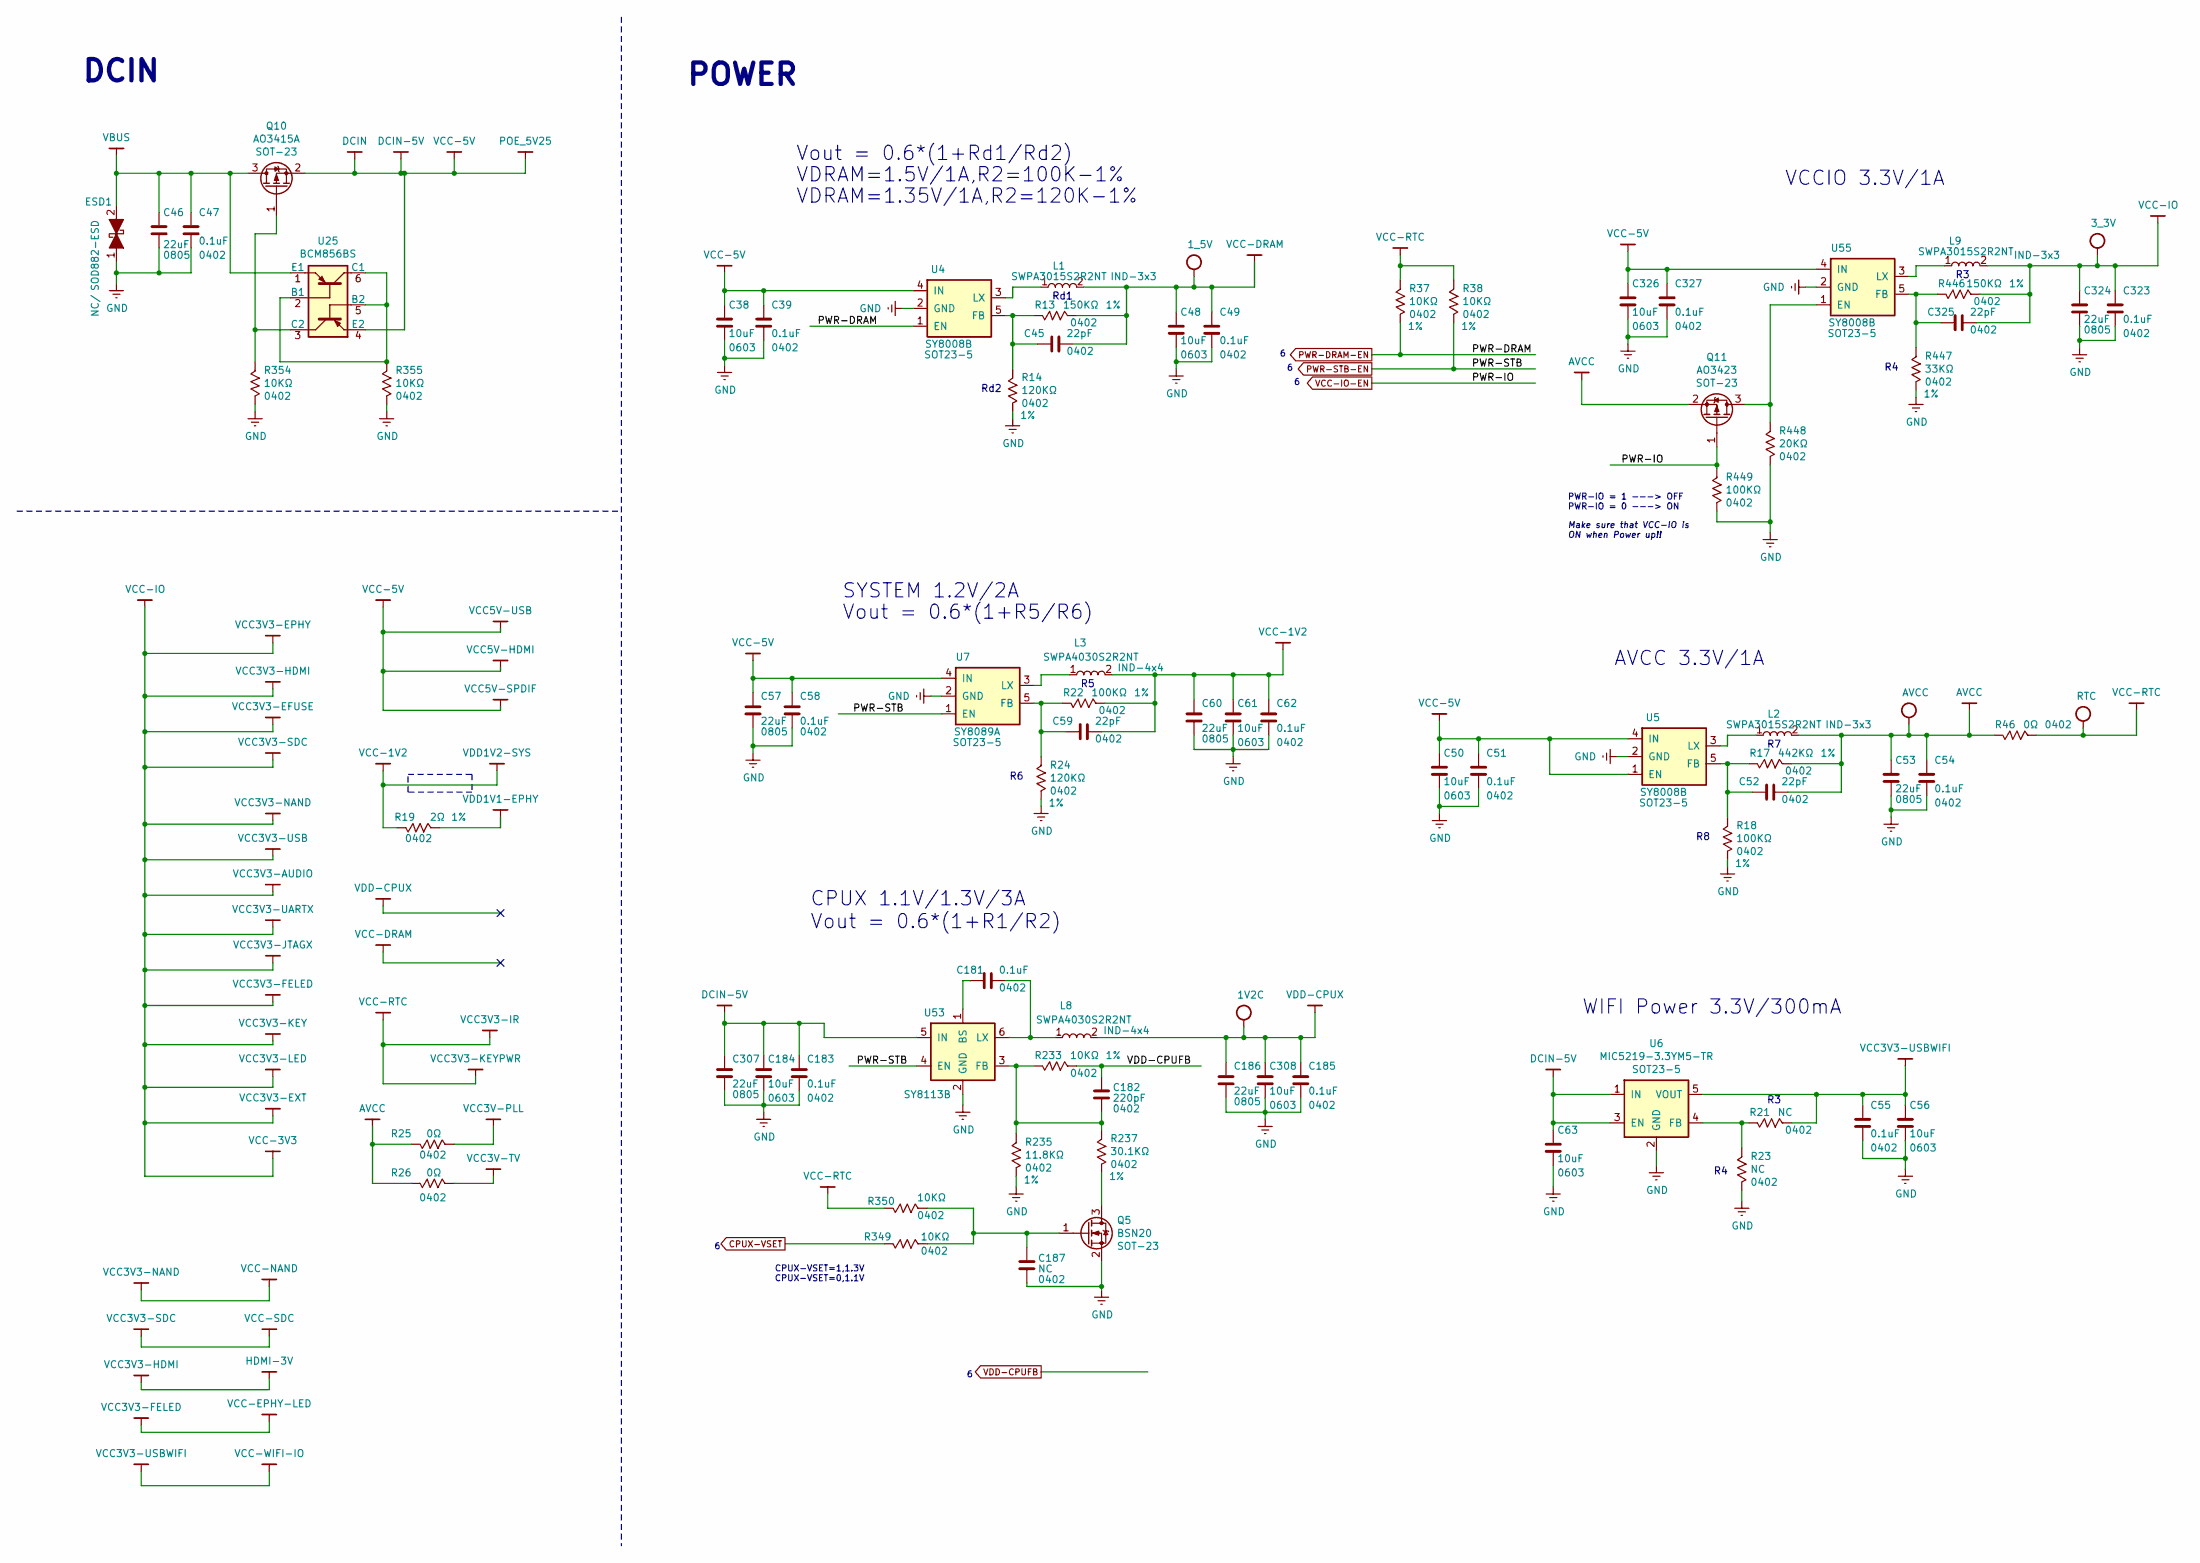
[picture p7: schematic POWER.sch]

Parts:
C38, C48, C50, C56, C61, C63, C184, C308, C326: CAP0603; Voltage 50V
C39, C45, C47, C49, C51, C52, C54, C55, C58, C59, C62, C181, C182, C183, C185, C187, C323, C325, C327: CAP0402; Voltage 50V
C46, C53, C57, C60, C186, C307, C324: CAP0805; Voltage 50V
ESD1: SOD882-ESD
L1, L2, L9: SWPA3015S2R2NT
L3, L8: SWPA4030S2R2NT
Q5: BSN20
Q10: AO3415A
Q11: AO3423
R13, R14, R17, R18, R19, R21, R22, R23, R24, R37, R38, R46, R233, R235, R237, R349, R350, R446, R447, R448, R449: RES402; RES0402; Tolerance 1%
R25, R26, R354, R355: RES402; RES0402; Tolerance x%
TP1, TP2, TP3, TP4, TP5: TestPoint
U4, U5, U55: SY8008B
U6: MIC5219-3.3YM5-TR; PST73133BETV
U7: SY8089A; SY8009A
U25: BCM856BS
U53: SY8113B

Connections:
AVCC: C52.1, C53.1, C54.1, L2.2, Q11.2 (S), R17.1, R25.2, R26.2, R46.2, TP4.1
CPUX-VSET: R349.2
DCIN: C38.1, C39.1, C50.1, C51.1, C57.1, C58.1, C63.1, C183.1, C184.1, C307.1, C326.1, C327.1, Q10.2 (S), U4.4 (IN), U5.1 (EN), U5.4 (IN), U6.1 (IN), U6.3 (EN), U7.4 (IN), U25.4 (E2), U53.5 (IN), U55.4 (IN)
GND: C38.2, C39.2, C46.2, C47.2, C48.2, C49.2, C50.2, C51.2, C53.2, C54.2, C55.2, C56.2, C57.2, C58.2, C60.2, C61.2, C62.2, C63.2, C183.2, C184.2, C185.2, C186.2, C187.2, C307.2, C308.2, C323.2, C324.2, C326.2, C327.2, ESD1.1 (A), Q5.2 (S), R14.2, R18.2, R23.2, R24.2, R235.2, R354.2, R355.2, R447.2, R448.2, R449.2, U4.2 (GND), U5.2 (GND), U6.2 (GND), U7.2 (GND), U53.2 (GND), U55.2 (GND)
HDMI-3V: C323.1, C324.1, C325.1, L9.2, R446.1, TP3.1
unnamed: C45.2, R13.2, R14.1, U4.5 (FB)
unnamed: C52.2, R17.2, R18.1, U5.5 (FB)
unnamed: C59.2, R22.2, R24.1, U7.5 (FB)
unnamed: C181.1, L8.1, U53.6 (LX)
unnamed: C181.2, U53.1 (BS)
unnamed: C182.2, R233.2, R235.1, R237.1, U53.3 (FB)
unnamed: C187.1, Q5.1 (G), R349.1, R350.1
unnamed: C325.2, R446.2, R447.1, U55.5 (FB)
unnamed: L1.1, U4.3 (LX)
unnamed: L2.1, U5.3 (LX)
unnamed: L3.1, U7.3 (LX)
unnamed: L9.1, U55.3 (LX)
unnamed: Q5.3 (D), R237.2
unnamed: Q10.1 (G), R354.1, U25.3 (C2)
unnamed: Q11.3 (D), R448.1, U55.1 (EN)
unnamed: R21.2, R23.1, U6.4 (FB)
unnamed: R355.1, U25.2 (B1), U25.5 (B2), U25.6 (C1)
PWR-DRAM-EN: R37.2, U4.1 (EN)
PWR-STB-EN: R38.2, U7.1 (EN), U53.4 (EN)
VBUS: C46.1, C47.1, ESD1.2 (K), Q10.3 (D), U25.1 (E1)
VCC3V-PLL: R25.1
VCC3V-TV: R26.1
VCC-1V2: C59.1, C60.1, C61.1, C62.1, L3.2, R19.2, R22.1
VCC-DRAM: C45.1, C48.1, C49.1, L1.2, R13.1, TP1.1
VCC-IO-EN: Q11.1 (G), R449.1
VCC-RTC: R37.1, R38.1, R46.1, R350.2, TP5.1
VCC-WIFI-IO: C55.1, C56.1, R21.1, U6.5 (VOUT)
VDD1V1-EPHY: R19.1
VDD-CPUFB: C182.1, R233.1
VDD-CPUX: C185.1, C186.1, C308.1, L8.2, TP2.1

Notes on the sheet:
DCIN
Vout = 0.6*(1+Rd1/Rd2)
VDRAM=1.5V/1A,R2=100K-1%
VDRAM=1.35V/1A,R2=120K-1%
Rd2
POWER
Rd1
SYSTEM 1.2V/2A
Vout = 0.6*(1+R5/R6)
CPUX-VSET=1,1.3V CPUX-VSET=0,1.1V
PWR-IO = 1 ---> OFF PWR-IO = 0 ---> ON
Make sure that VCC-IO is ON when Power up!!
CPUX 1.1V/1.3V/3A Vout = 0.6*(1+R1/R2)
VCCIO 3.3V/1A
AVCC 3.3V/1A
WIFI Power 3.3V/300mA
