t-cun/OrangePiR1-schematics/KiCad/USB-TO-EMAC.sch

## KiCad design KiCad/USB-TO-EMAC.sch (2020-04-20)

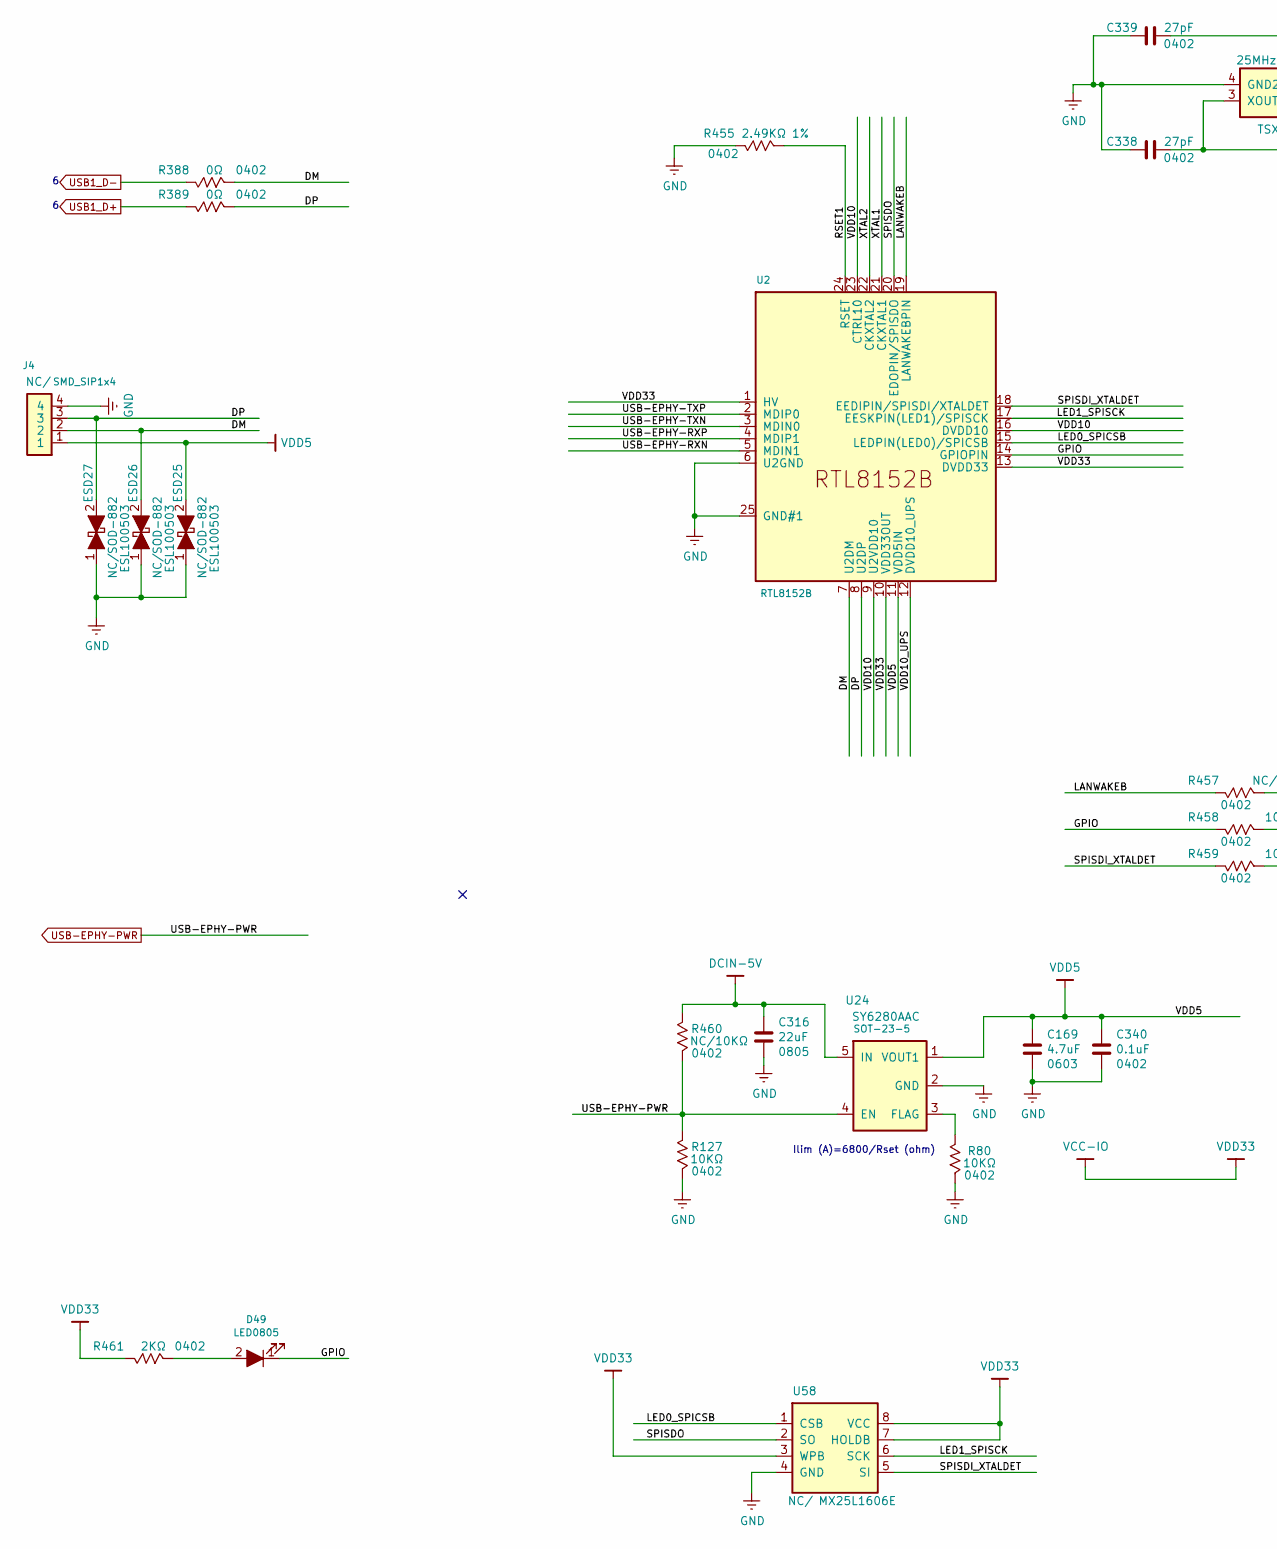
[picture p8: schematic USB-TO-EMAC.sch, part in row 1, column 1]

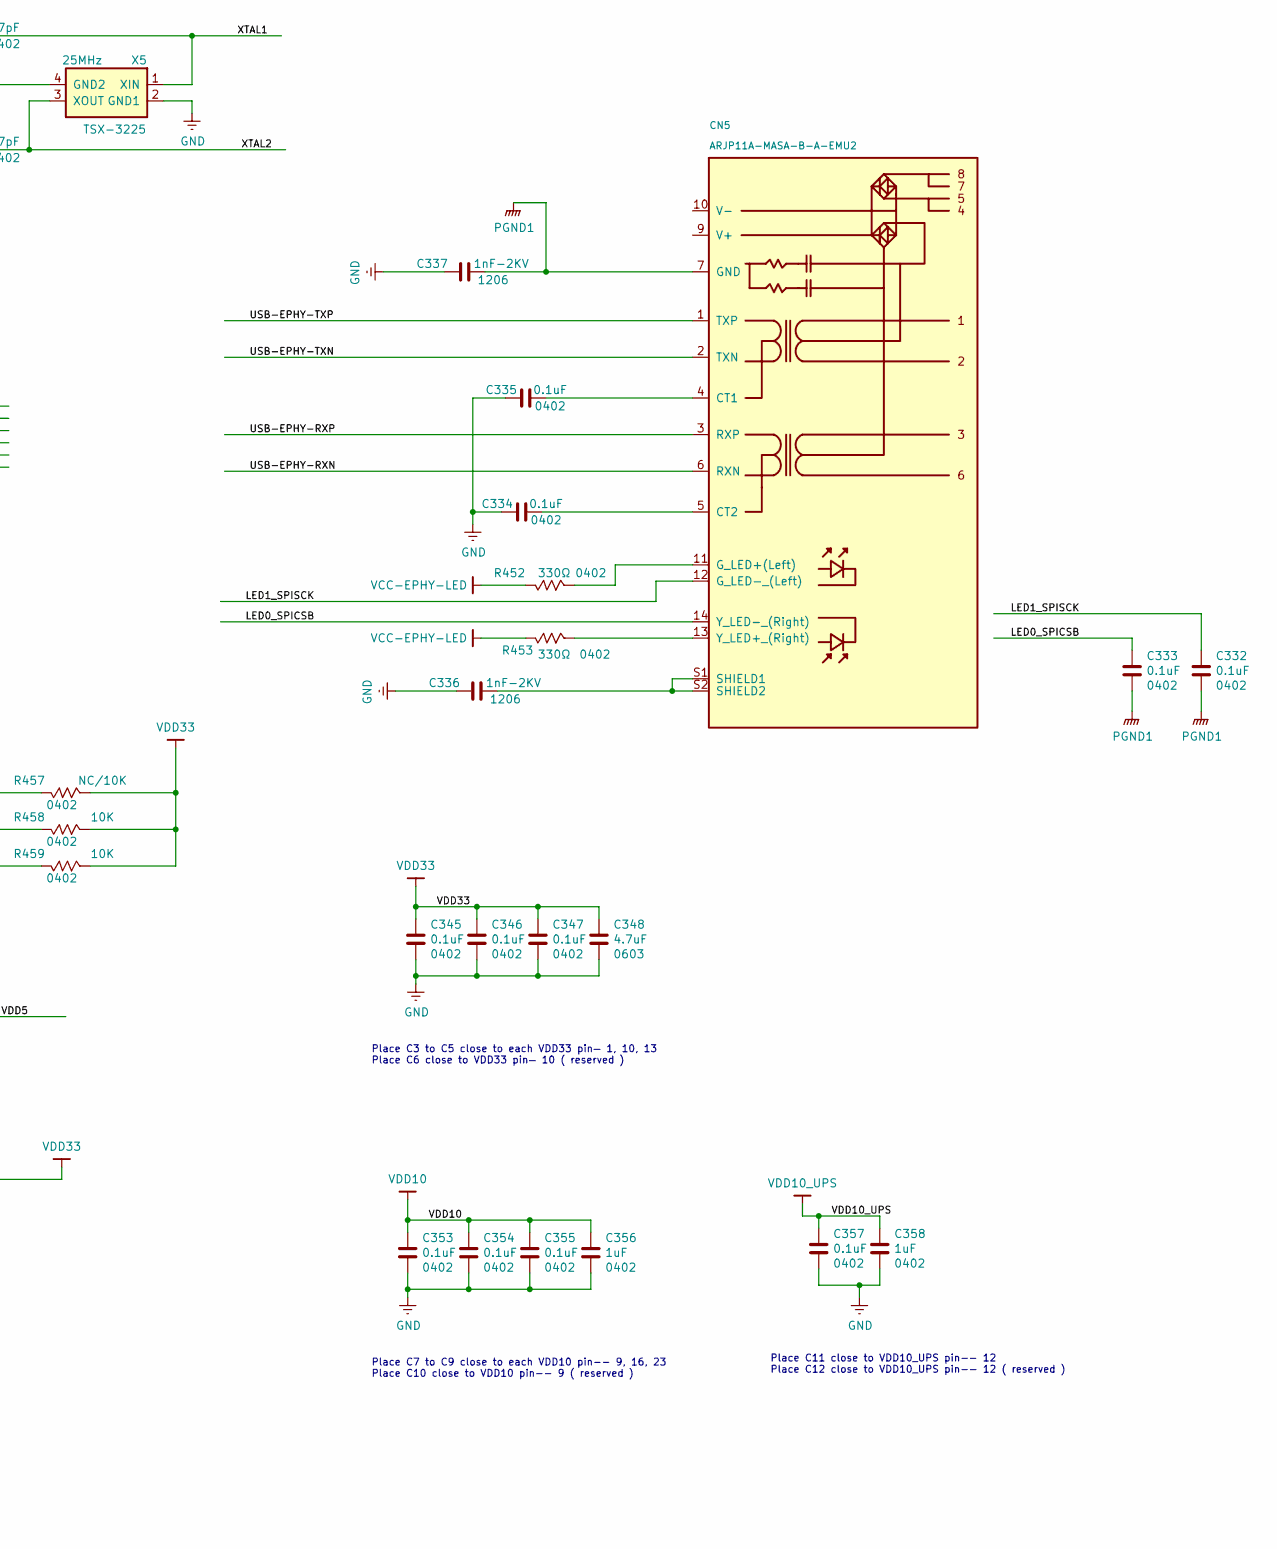
[picture p9: schematic USB-TO-EMAC.sch, part in row 1, column 2]

Parts:
C169, C348: CAP0603; Voltage 50V
C316: CAP0805; Voltage 50V
C332, C333, C334, C335, C338, C339, C340, C345, C346, C347, C353, C354, C355, C356, C357, C358: CAP0402; Voltage 50V
C336, C337: CAP1206; Voltage 50V
CN5: ARJP11A-MASA-B-A-EMU2
D49: LED0805
ESD25, ESD26, ESD27: ESL100503; PESD5V0S1BL
J4: SMD_SIP1x4
R80, R127, R388, R389, R452, R453, R455, R457, R458, R459, R460, R461: RES402; RES0402; Tolerance 1%
U2: RTL8152B
U24: SY6280AAC
U58: MX25L1606E; MX25L1606EM1
X5: TSX-3225

Connections:
DCIN-5V: C316.1, R460.2, U24.5 (IN)
DM: ESD26.2 (K), J4.2, R388.1, U2.7 (U2DM)
DP: ESD27.2 (K), J4.3, R389.1, U2.8 (U2DP)
GND: C169.2, C316.2, C334.2, C335.2, C336.2, C337.2, C338.2, C339.2, C340.2, C345.2, C346.2, C347.2, C348.2, C353.2, C354.2, C355.2, C356.2, C357.2, C358.2, ESD25.1 (A), ESD26.1 (A), ESD27.1 (A), J4.4, R80.1, R127.1, R455.2, U2.6 (U2GND), U2.25 (GND#1), U24.2 (GND), U58.4 (GND), X5.2 (GND1), X5.4 (GND2)
GPIO: D49.1 (K), R458.2, U2.14 (GPIOPIN)
LANWAKEB: R457.2, U2.19 (LANWAKEBPIN)
LED0_SPICSB: C333.1, CN5.14 (Y_LED-_(Right)), U2.15 (LEDPIN(LED0)/SPICSB), U58.1 (CSB)
LED1_SPISCK: C332.1, CN5.12 (G_LED-_(Left)), U2.17 (EESKPIN(LED1)/SPISCK), U58.6 (SCK)
unnamed: C334.1, CN5.5 (CT2)
unnamed: C335.1, CN5.4 (CT1)
unnamed: C336.1, CN5.S1 (SHIELD1), CN5.S2 (SHIELD2)
unnamed: CN5.11 (G_LED+(Left)), R452.1
unnamed: CN5.13 (Y_LED+_(Right)), R453.1
unnamed: D49.2 (A), R461.1
unnamed: R80.2, U24.3 (FLAG)
PGND1: C332.2, C333.2, C337.1, CN5.7 (GND)
RSET1: R455.1, U2.24 (RSET)
SPISDI_XTALDET: R459.2, U2.18 (EEDIPIN/SPISDI/XTALDET), U58.5 (SI)
SPISDO: U2.20 (EDOPIN/SPISDO), U58.2 (SO)
USB1_D+: R389.2
USB1_D-: R388.2
USB-EPHY-PWR: R127.2, R460.1, U24.4 (EN)
USB-EPHY-RXN: CN5.6 (RXN), U2.5 (MDIN1)
USB-EPHY-RXP: CN5.3 (RXP), U2.4 (MDIP1)
USB-EPHY-TXN: CN5.2 (TXN), U2.3 (MDIN0)
USB-EPHY-TXP: CN5.1 (TXP), U2.2 (MDIP0)
VCC-EPHY-LED: R452.2, R453.2
VCC-IO: C345.1, C346.1, C347.1, C348.1, R457.1, R458.1, R459.1, R461.2, U2.1 (HV), U2.10 (VDD33OUT), U2.13 (DVDD33), U58.3 (WPB), U58.7 (HOLDB), U58.8 (VCC)
VDD5: C169.1, C340.1, ESD25.2 (K), J4.1, U2.11 (VDD5IN), U24.1 (VOUT1)
VDD10: C353.1, C354.1, C355.1, C356.1, U2.9 (U2VDD10), U2.16 (DVDD10), U2.23 (CTRL10)
VDD10_UPS: C357.1, C358.1, U2.12 (DVDD10_UPS)
XTAL1: C339.1, U2.21 (CKXTAL1), X5.1 (XIN)
XTAL2: C338.1, U2.22 (CKXTAL2), X5.3 (XOUT)

Notes on the sheet:
Ilim (A)=6800/Rset (ohm)
Place C3 to C5 close to each VDD33 pin— 1, 10, 13 Place C6 close to VDD33 pin— 10 ( reserved )
Place C7 to C9 close to each VDD10 pin-- 9, 16, 23 Place C10 close to VDD10 pin-- 9 ( reserved )
Place C11 close to VDD10_UPS pin-- 12 Place C12 close to VDD10_UPS pin-- 12 ( reserved )
