t-cun/OrangePiR1-schematics/KiCad/USB.sch

## KiCad design KiCad/USB.sch (2020-04-20)

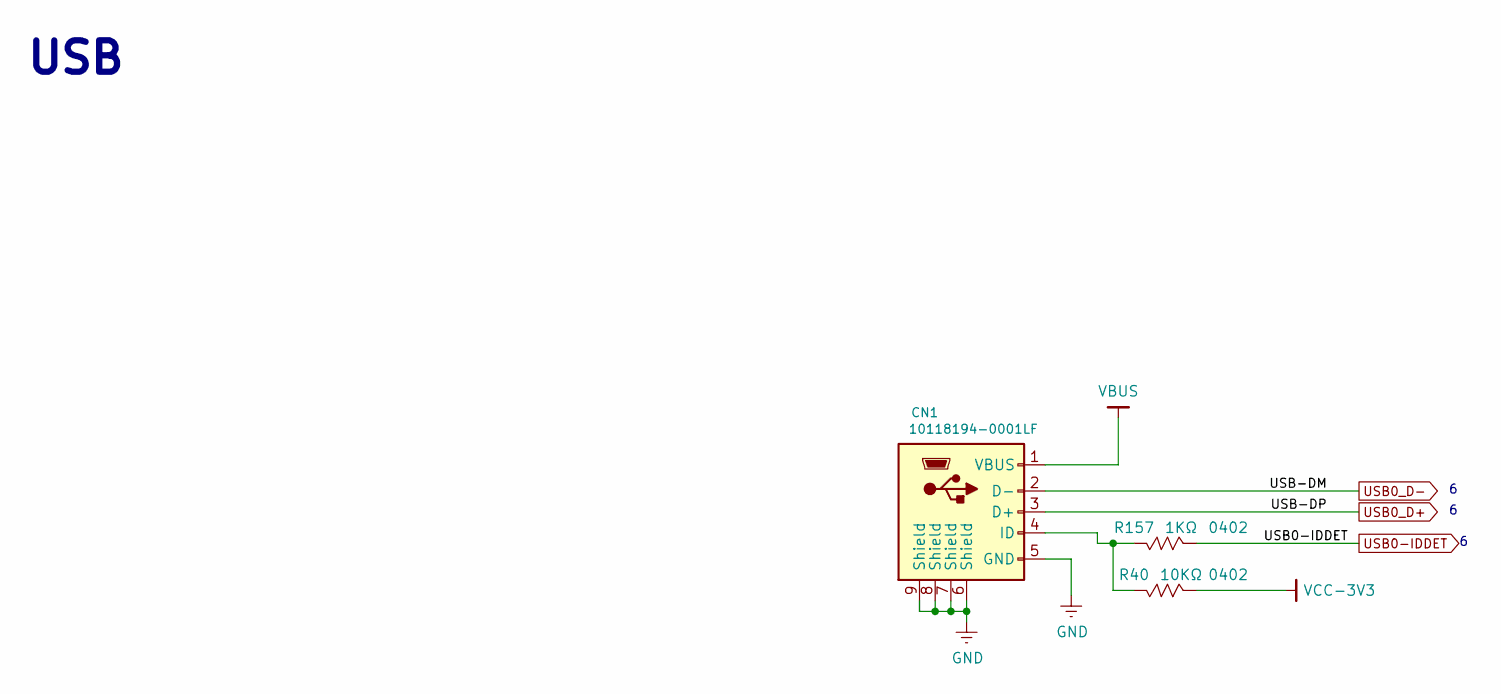
[picture p10: schematic USB.sch]

Parts:
CN1: 10118194-0001LF
R40, R157: RES402; RES0402; Tolerance x%

Connections:
GND: CN1.5 (GND), CN1.6 (Shield), CN1.7 (Shield), CN1.8 (Shield), CN1.9 (Shield)
unnamed: CN1.4 (ID), R40.2, R157.2
USB0-IDDET: R157.1
USB0_D+: CN1.3 (D+)
USB0_D-: CN1.2 (D-)
VBUS: CN1.1 (VBUS)
VCC-3V3: R40.1

Notes on the sheet:
USB
