t-cun/OrangePiR1-schematics/KiCad/WIFI.sch

## KiCad design KiCad/WIFI.sch (2020-04-20)

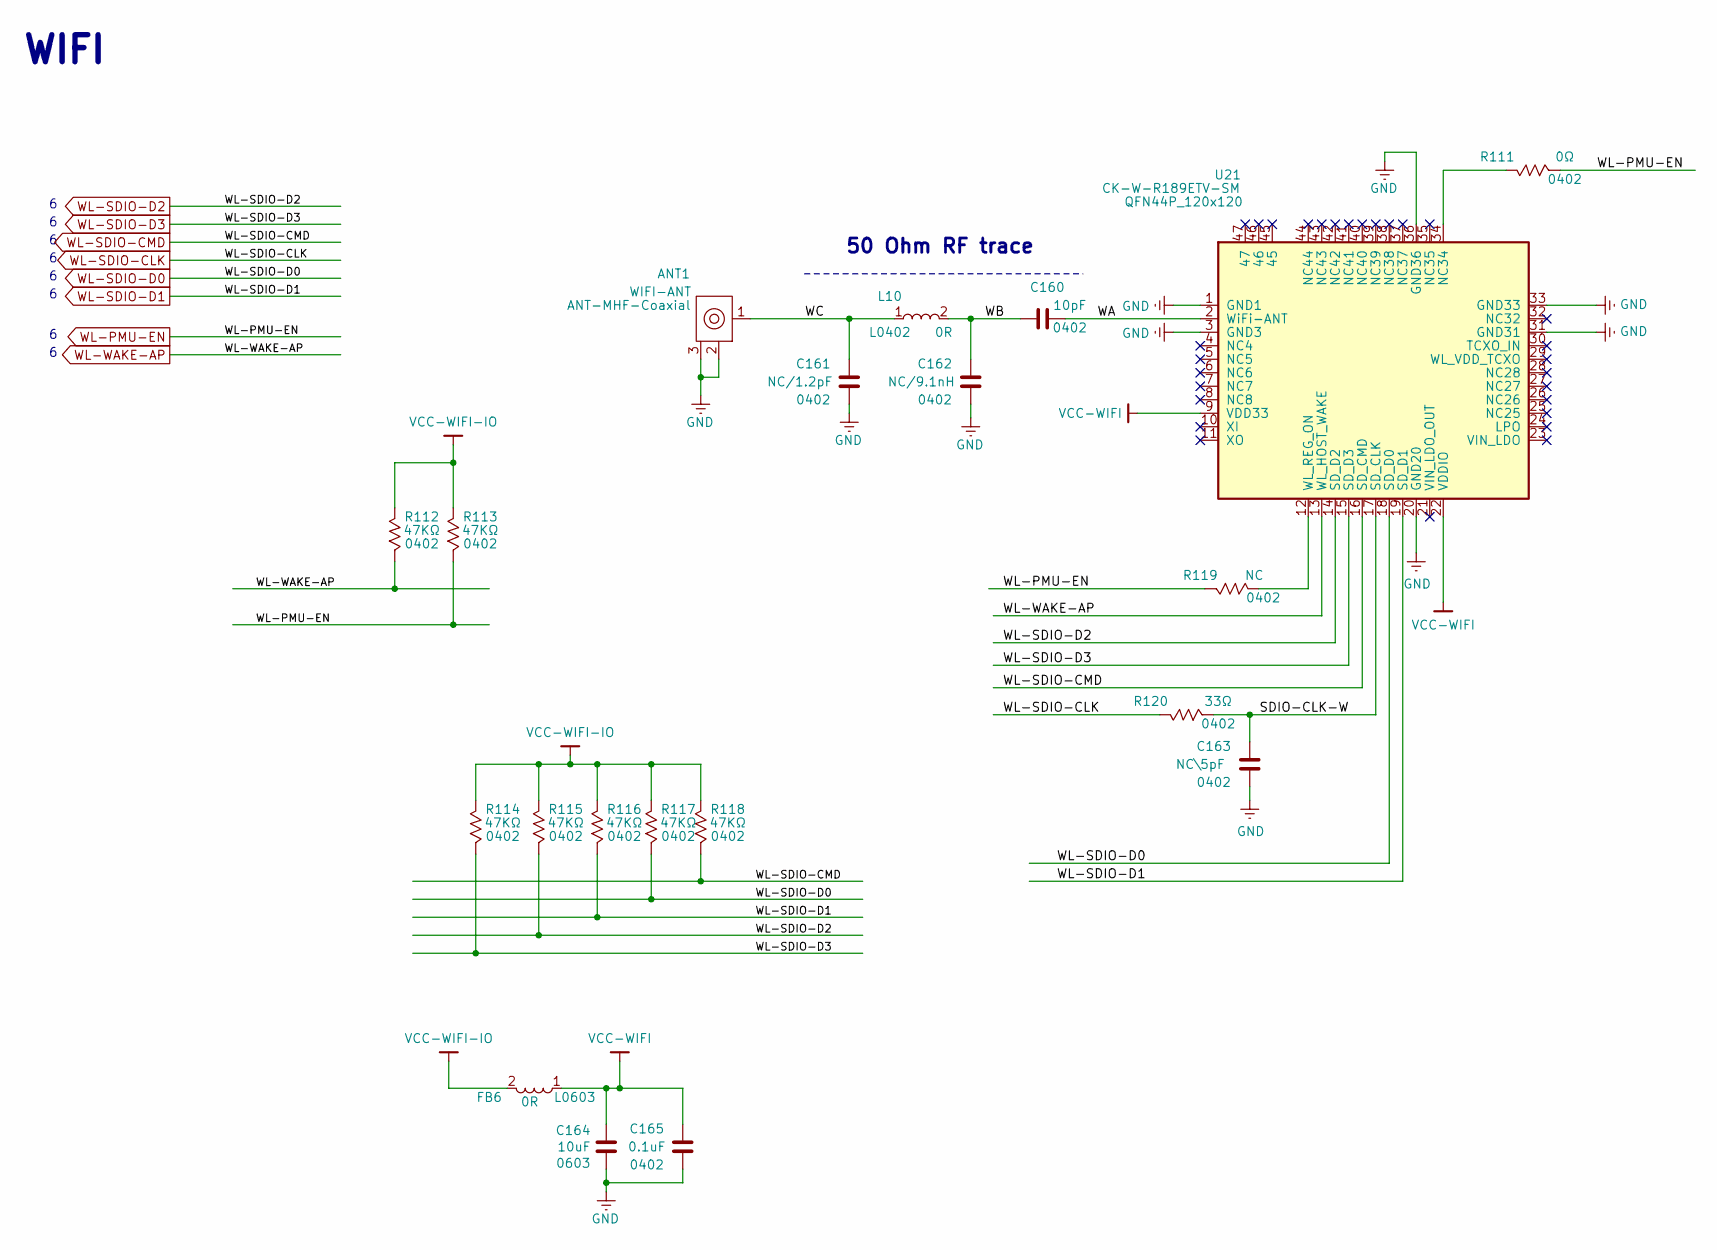
[picture p11: schematic WIFI.sch]

Parts:
ANT1: WIFI-ANT; 2337019-1
C160, C161, C162, C163, C165: CAP0402; Voltage 50V
C164: CAP0603; Voltage 50V
FB6: L0603
L10: L0402
R111, R112, R113, R114, R115, R116, R117, R118, R119, R120: RES402; RES0402; Tolerance x%
U21: CK-W-R189ETV-SM

Connections:
GND: ANT1.2, ANT1.3, C161.1, C162.1, C163.1, C164.1, C165.1, U21.1 (GND1), U21.3 (GND3), U21.20 (GND20), U21.31 (GND31), U21.33 (GND33), U21.36 (GND36)
unnamed: R111.2, U21.34 (NC34)
unnamed: R119.2, U21.12 (WL_REG_ON)
SDIO-CLK-W: C163.2, R120.1, U21.17 (SD_CLK)
VCC-WIFI: C164.2, C165.2, FB6.1, U21.9 (VDD33), U21.22 (VDDIO)
VCC-WIFI-IO: FB6.2, R112.2, R113.2, R114.2, R115.2, R116.2, R117.2, R118.2
WA: C160.1, U21.2 (WiFi-ANT)
WB: C160.2, C162.2, L10.2
WC: ANT1.1, C161.2, L10.1
WL-PMU-EN: R111.1, R113.1, R119.1
WL-SDIO-CLK: R120.2
WL-SDIO-CMD: R118.1, U21.16 (SD_CMD)
WL-SDIO-D0: R117.1, U21.18 (SD_D0)
WL-SDIO-D1: R116.1, U21.19 (SD_D1)
WL-SDIO-D2: R115.1, U21.14 (SD_D2)
WL-SDIO-D3: R114.1, U21.15 (SD_D3)
WL-WAKE-AP: R112.1, U21.13 (WL_HOST_WAKE)

Notes on the sheet:
50 Ohm RF trace
WIFI
